RochaDotPng/ProjectLinkplas/public/images/equipa/equipa.jpg

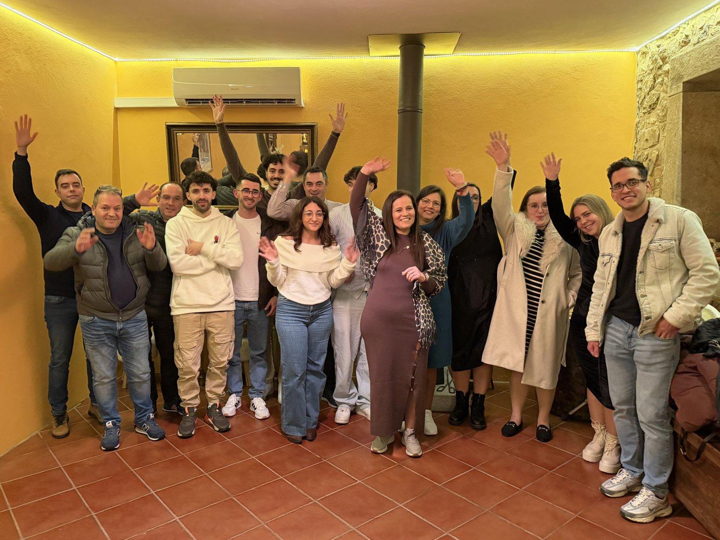
public/images/equipa/equipa.jpg
