RochaDotPng/ProjectLinkplas/public/images/equipa/rui-silva.jpg

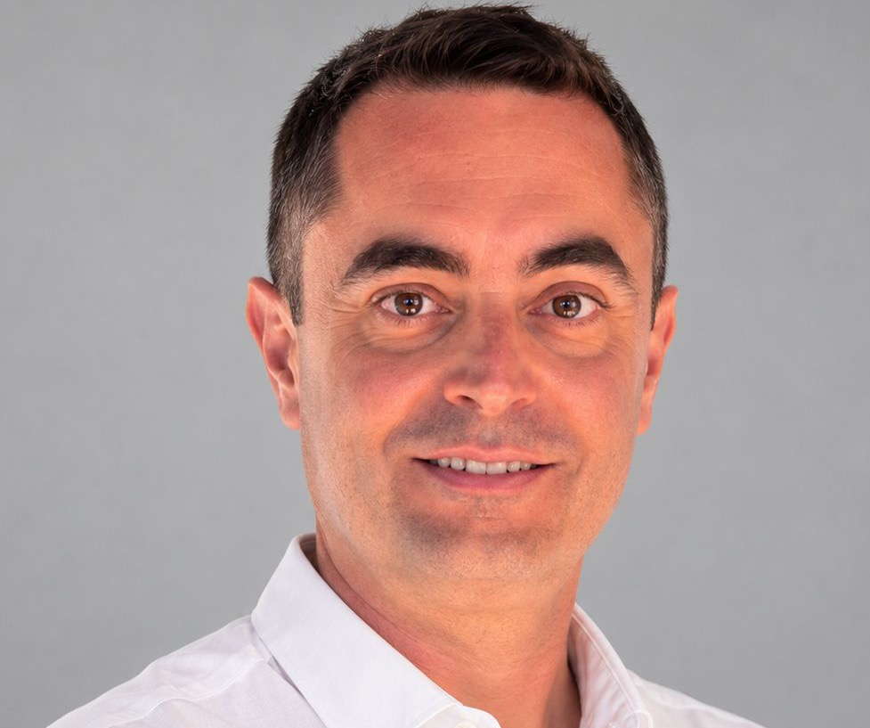
public/images/equipa/rui-silva.jpg
