RochaDotPng/ProjectLinkplas/README.md

# LinkPlas Website

All development made by:

- André Silva
- José Seiça
