RochaDotPng/ProjectLinkplas/public/files/ZØR_LINKPLAS_Kit.pdf

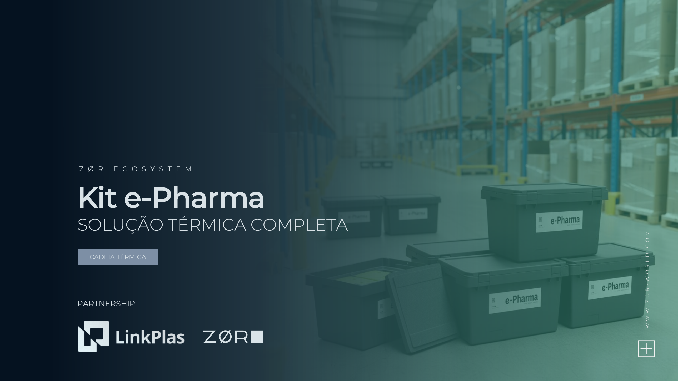
[picture p3: page 1]

### Z Ø R E C O S Y S T E M

# Kit

e

# -Pharma

# SOLUÇÃO TÉRMICA COMPLETA

CADEIA TÉRMICA

W W W . Z O R - W O R L D . C O M

## PARTNERSHIP

2

# Departamento de I&D

### D E S I G N & E N G E N H A R I A

Uma equipa multidisciplinar composta por especialistas em diferentes áreas, como a biotecnologia, a alimentação, a biomedicina, a engenharia, o design e a cadeia de frio, desenvolve-se através de uma perspetiva de Design Thinking, combinando a experiência profissional com mentalidades criativas.

# Sustentabilidade

### I N I C I A T I V A S

A ZØR tem vindo a desenvolver soluções cada vez mais responsáveis e sustentáveis, associando a cada produto novas iniciativas que refletem esse compromisso: GoGreen, para materiais de menor impacto ambiental; Re-Kool, para sistemas com componentes retornáveis e reutilizáveis; e ZØR Loop, para modelos totalmente circulares. Um percurso contínuo rumo a uma produção mais consciente.

### C Â M A R A T E R M O D I N Â M I C A + S I M U L A Ç Ã O V I R T U A L

Laboratório de performance térmica dedicado a qualificações em ambiente controlado
e validações em contexto operacional de soluções da cadeia térmica. O laboratório dispõe de uma equipa qualificada, uma câmara climática walk-in que permite simular diferentes perfis térmicas exteriores e um software avançado de simulação numérica.

# Laboratório

# GøGreen

# Missão e Visão

### Z Ø R T H E R M A L

O ZØR World é um grupo que reúne várias empresas e competências complementares, dentro e fora da cadeia térmica, unidas por uma visão comum de inovação e sustentabilidade. No seu núcleo está a ZØR Thermal, dedicada ao desenvolvimento de soluções para a cadeia térmica, que integra o ZØR FabLab e uma equipa de I&D focada na melhoria contínua de desempenho e eficiência. Através da ZØR Monitoring, oferecemos serviços digitais de gestão e monitorização com sistemas conectados, reforçando o controlo e a fiabilidade em toda a operação.

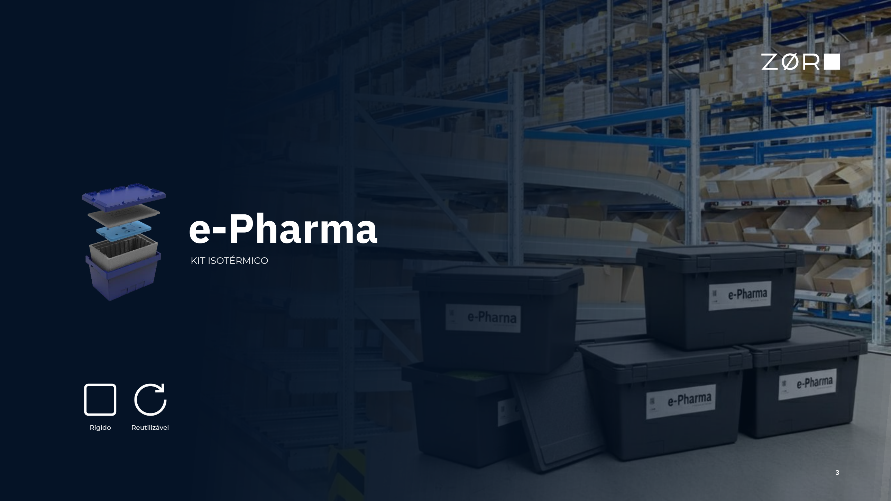
[picture p4: page 3]

# e-Pharma

### KIT ISOTÉRMICO

3

Rígido Reutilizável

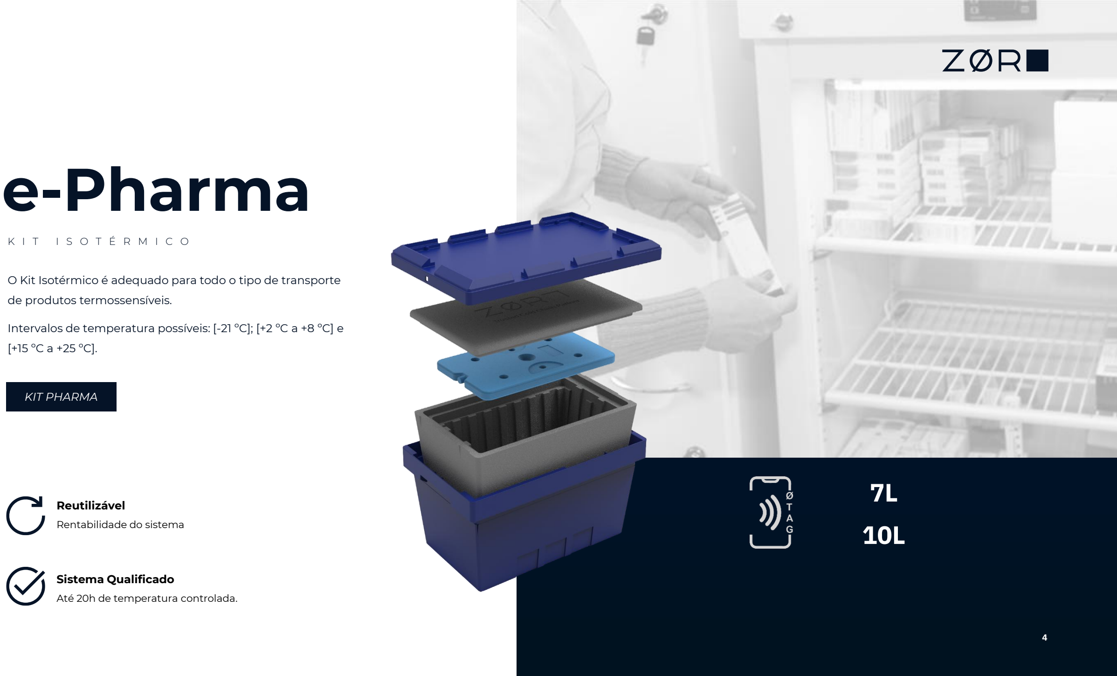
[picture p5: page 4]

O Kit Isotérmico é adequado para todo o tipo de transporte de produtos termossensíveis.

Intervalos de temperatura possíveis: [

-21 ºC]; [+2 ºC a +8 ºC] e

[+15 ºC a +25 ºC]. e-Pharma

K I T I S O T É R M I C O

KIT PHARMA

4

1

0

L

7L

Sistema Qualificado
Até

2

0h de temperatura controlada

Reutilizável
Rentabilidade do sistema

# e-Pharma Kit isotérmico

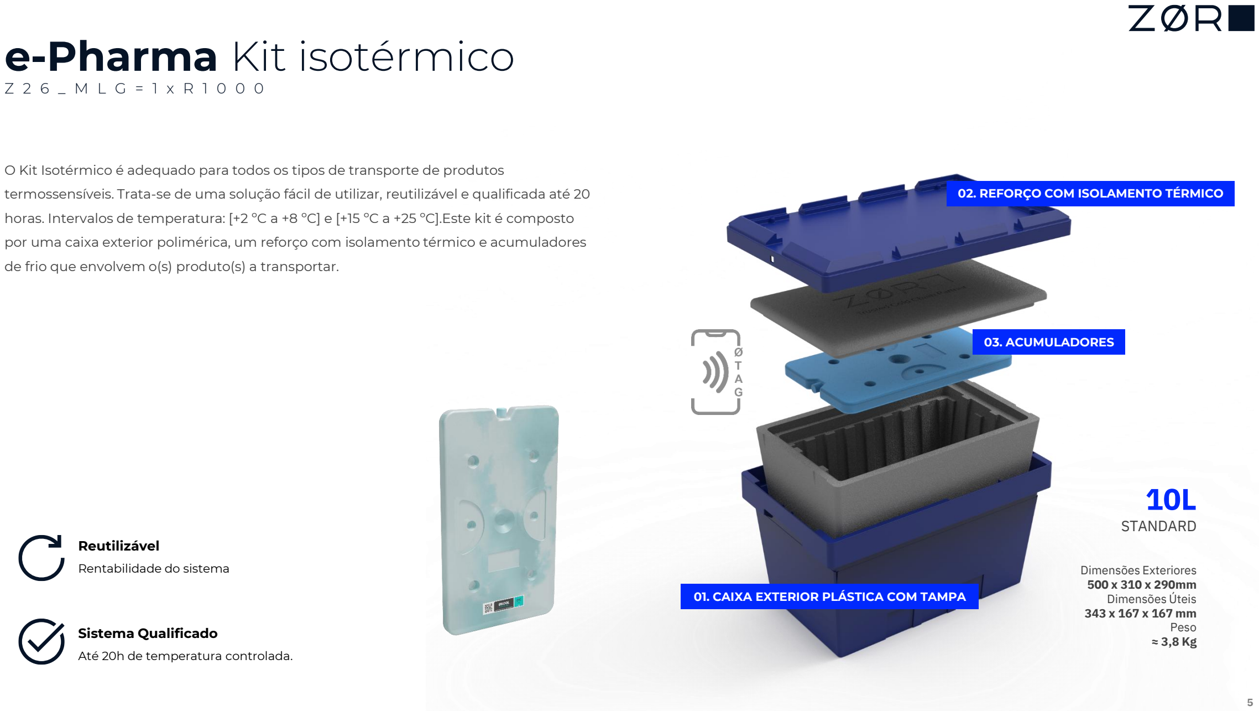
[picture p6: page 5]

5

### Z 2 6 _ M L G = 1 x R 1 0 0 0

10L

STANDARD

Dimensões Exteriores
500 x 310 x 290mm
Dimensões Úteis
343 x 167 x 167 mm
Peso
≈ 3,8 Kg

O Kit Isotérmico é adequado para todos os tipos de transporte de produtos termossensíveis. Trata-se de uma solução fácil de utilizar, reutilizável e qualificada até 20 horas. Intervalos de temperatura: [+2 ºC a +8 ºC] e [+15 ºC a +25 ºC].Este kit é composto por uma caixa exterior polimérica, um reforço com isolamento térmico e acumuladores de frio que envolvem o(s) produto(s) a transportar.

### 02. REFORÇO COM ISOLAMENTO TÉRMICO

### 01. CAIXA EXTERIOR PLÁSTICA COM TAMPA

### 03. ACUMULADORES

Sistema Qualificado
Até 20h de temperatura controlada.

Reutilizável
Rentabilidade do sistema

# e-Pharma Kit isotérmico

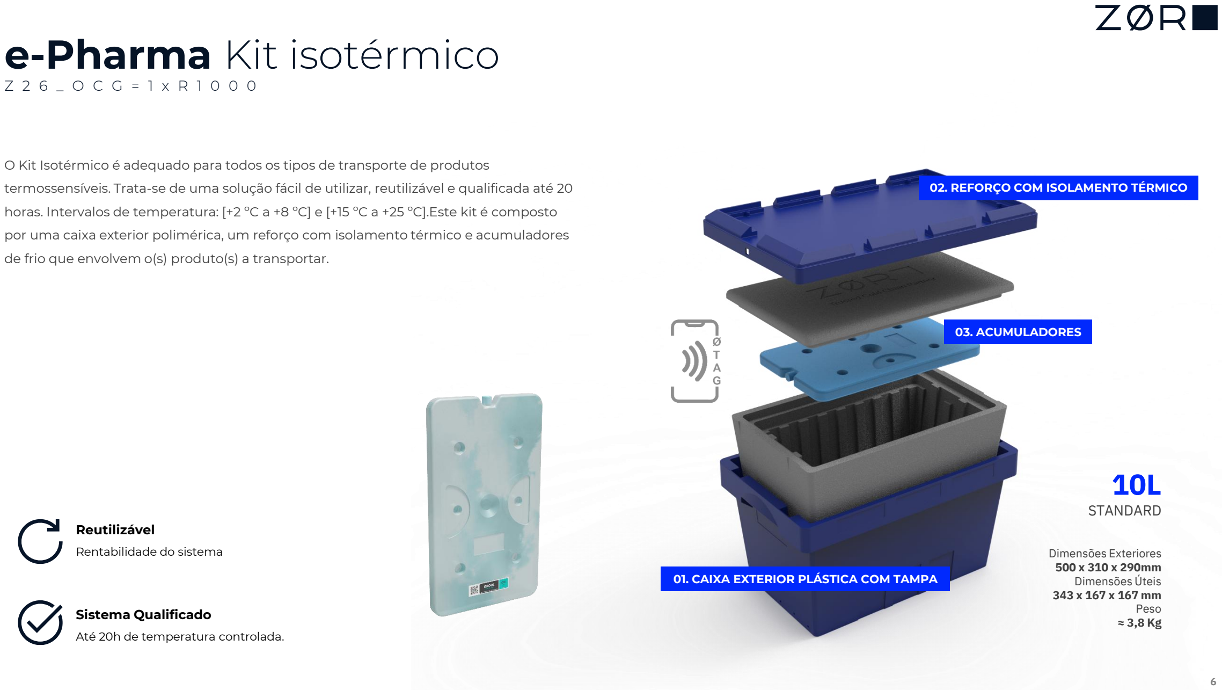
[picture p7: page 6]

6

### Z 2 6 _ O C G = 1 x R 1 0 0 0

10L

STANDARD

Dimensões Exteriores
500 x 310 x 290mm
Dimensões Úteis
343 x 167 x 167 mm
Peso
≈ 3,8 Kg

### 02. REFORÇO COM ISOLAMENTO TÉRMICO

### 01. CAIXA EXTERIOR PLÁSTICA COM TAMPA

### 03. ACUMULADORES

Sistema Qualificado
Até 20h de temperatura controlada.

Reutilizável
Rentabilidade do sistema

O Kit Isotérmico é adequado para todos os tipos de transporte de produtos termossensíveis. Trata-se de uma solução fácil de utilizar, reutilizável e qualificada até 20 horas. Intervalos de temperatura: [+2 ºC a +8 ºC] e [+15 ºC a +25 ºC].Este kit é composto por uma caixa exterior polimérica, um reforço com isolamento térmico e acumuladores de frio que envolvem o(s) produto(s) a transportar.

# e-Pharma Kit isotérmico

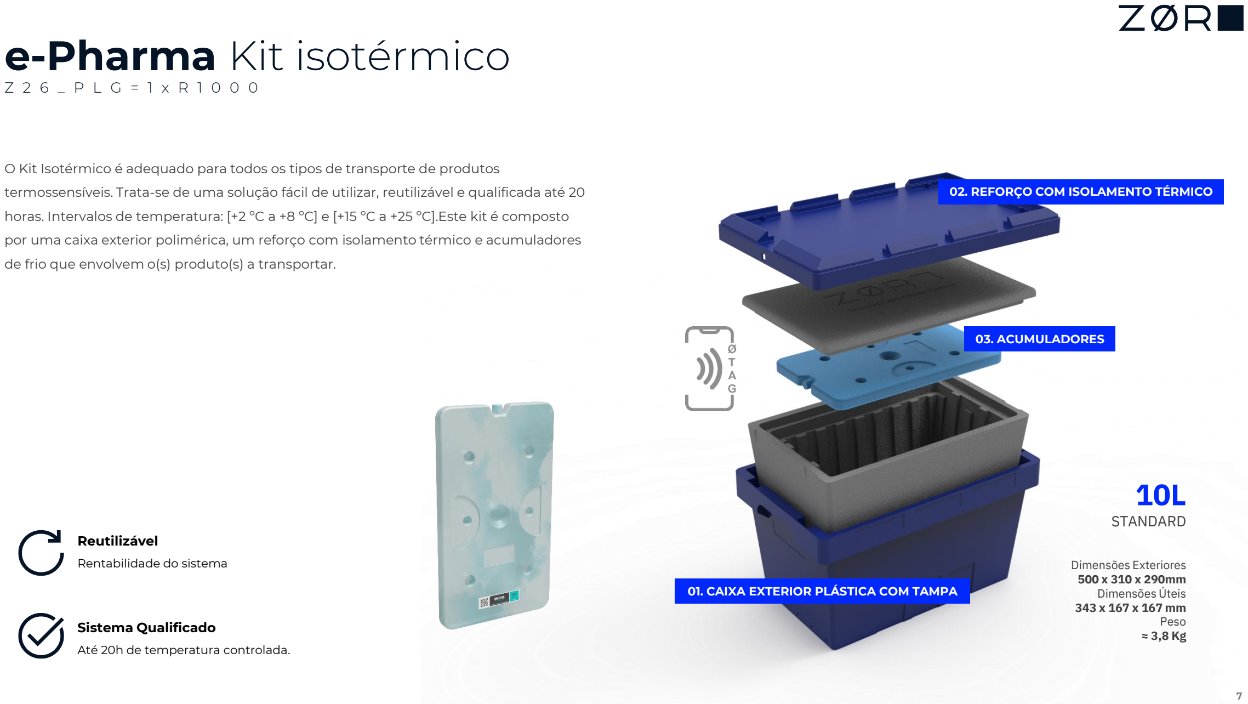
[picture p8: page 7]

7

10L

STANDARD

Dimensões Exteriores
500 x 310 x 290mm
Dimensões Úteis
343 x 167 x 167 mm
Peso
≈ 3,8 Kg

### Z 2 6 _ P L G = 1 x R 1 0 0 0

### 02. REFORÇO COM ISOLAMENTO TÉRMICO

### 01. CAIXA EXTERIOR PLÁSTICA COM TAMPA

### 03. ACUMULADORES

Sistema Qualificado
Até 20h de temperatura controlada.

Reutilizável
Rentabilidade do sistema

O Kit Isotérmico é adequado para todos os tipos de transporte de produtos termossensíveis. Trata-se de uma solução fácil de utilizar, reutilizável e qualificada até 20 horas. Intervalos de temperatura: [+2 ºC a +8 ºC] e [+15 ºC a +25 ºC].Este kit é composto por uma caixa exterior polimérica, um reforço com isolamento térmico e acumuladores de frio que envolvem o(s) produto(s) a transportar.

# e-Pharma Kit isotérmico

# e-Pharma Kit isotérmico

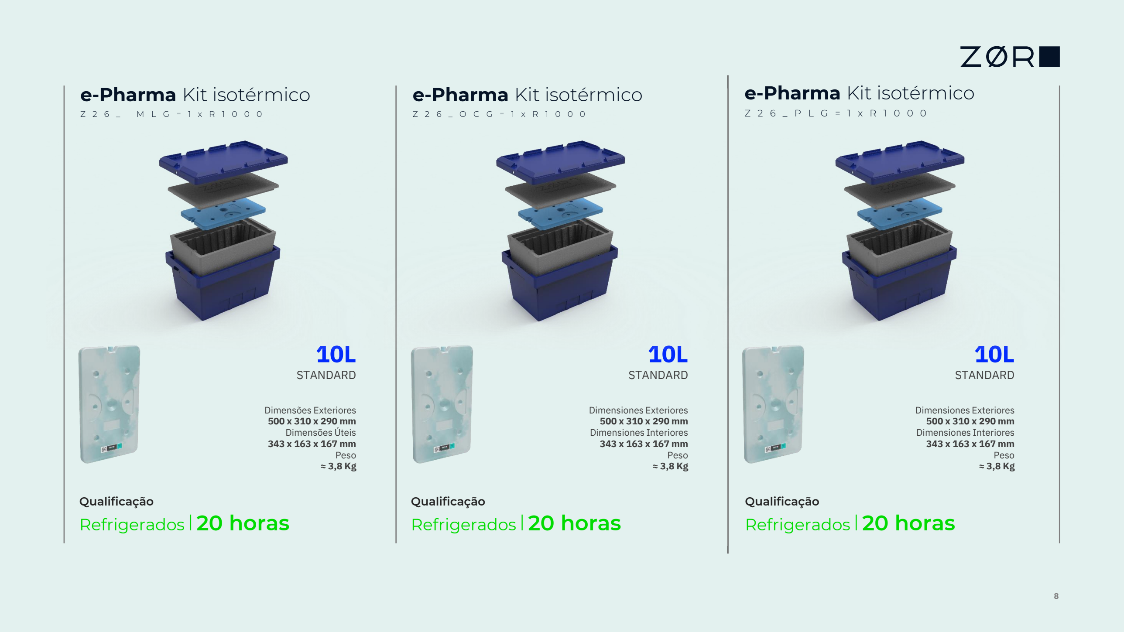
[picture p9: page 8]

10L

STANDARD

Dimensiones Exteriores
500 x 310 x 290 mm
Dimensiones Interiores
343 x 163 x 167 mm
Peso
≈ 3,8 Kg

8

Z 2 6 _ M L G = 1 x R 1 0 0 0

Z 2 6 _ O C G = 1 x R 1 0 0 0

# e-Pharma Kit isotérmico

Z 2 6 _ P L G = 1 x R 1 0 0 0

# Refrigerados l 20 horas

### Qualificação

# Refrigerados l 20 horas

### Qualificação

# Refrigerados l 20 horas

### Qualificação

10L

STANDARD

Dimensões Exteriores
500 x 310 x 290 mm
Dimensões Úteis
343 x 163 x 167 mm
Peso
≈ 3,8 Kg

10L

STANDARD

Dimensiones Exteriores
500 x 310 x 290 mm
Dimensiones Interiores
343 x 163 x 167 mm
Peso
≈ 3,8 Kg

# e-Pharma Kit isotérmico

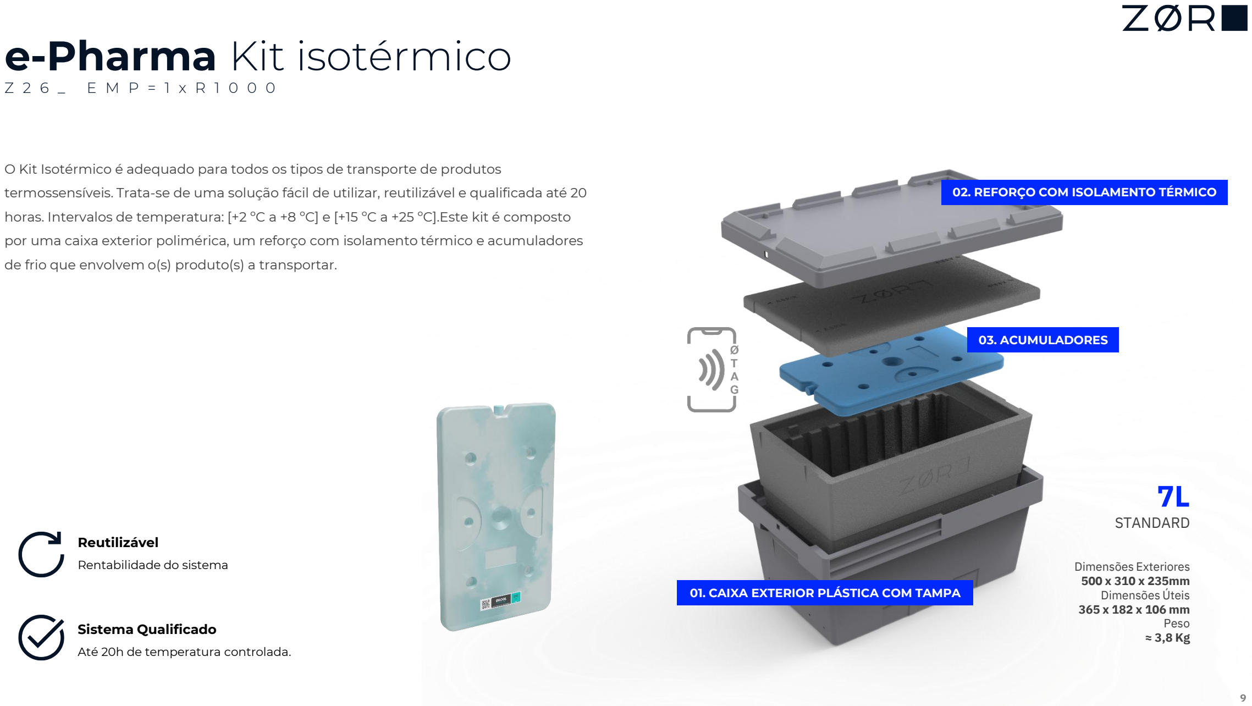
[picture p10: page 9]

9

7L

STANDARD

Dimensões Exteriores
500 x 310 x 235mm
Dimensões Úteis
365 x 182 x 106 mm
Peso
≈ 3,8 Kg

### Z 2 6 _ E M P = 1 x R 1 0 0 0

### 02. REFORÇO COM ISOLAMENTO TÉRMICO

### 01. CAIXA EXTERIOR PLÁSTICA COM TAMPA

### 03. ACUMULADORES

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

Sistema Qualificado
Até 20h de temperatura controlada.

Reutilizável
Rentabilidade do sistema

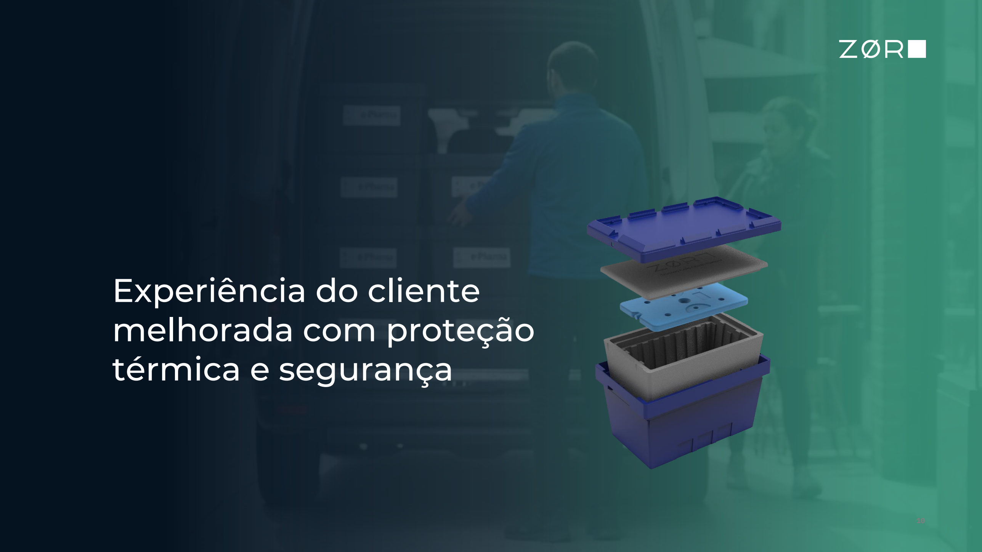
[picture p11: page 10]

10

# Experiência do cliente melhorada com proteção térmica e segurança

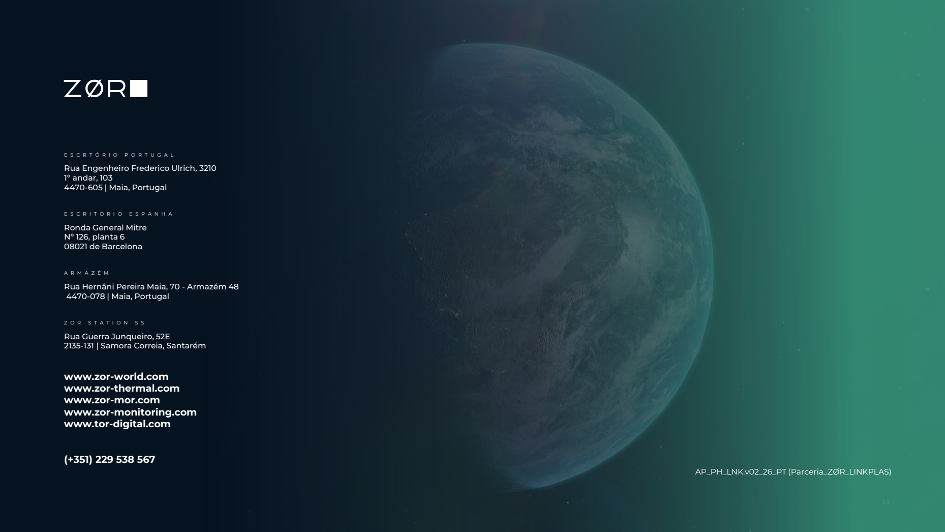
[picture p12: page 11]

11

E S C R T Ó R I O P O R T U G A L
Rua Engenheiro Frederico Ulrich, 3210 1º andar, 103
4470-605 | Maia, Portugal

E S C R I T Ó R I O E S P A NHA
Ronda General Mitre
Nº 126, planta 6
08021 de Barcelona

A R M A Z É M
Rua Hernâni Pereira Maia, 70 - Armazém 48
4470-078 | Maia, Portugal

Z O R S T A T I O N S S
Rua Guerra Junqueiro, 52E
2135-131 | Samora Correia, Santarém

### www.zor-world.com www.zor-thermal.com www.zor-mor.com www.zor-monitoring.com www.tor-digital.com

(+351) 229 538 567
AP_PH_LNK.v02_26_PT (Parceria_ZØR_LINKPLAS)
