RochaDotPng/ProjectLinkplas/src/assets/logos/LEIA-ME.md

# Logótipos de clientes e parceiros

Os ficheiros desta pasta aparecem sozinhos na faixa "Mais de 20 clientes ativos confiam na
LinkPlas" da página inicial e na lista de parceiros. Não é preciso mexer no código.

- Formatos: SVG (preferido), PNG ou WebP, com fundo transparente. Um JPG também serve: o fundo
  branco desaparece na faixa da página inicial, mas a imagem só fica bem sobre fundos claros.
- Use a versão do logótipo feita para fundo claro. Uma versão com letras brancas ou muito claras
  (feita para fundo escuro) quase não se lê no site.
- Nome do ficheiro: o nome da empresa em minúsculas, sem espaços nem acentos, por exemplo
  `plural.svg`, `platec.svg`, `zor.svg`, `polisport.svg`, `empifarma.svg`, `ocp.svg`,
  `medlog.svg`, `coprax.svg`.
- Um ficheiro com o nome de um parceiro da lista substitui o nome em texto desse parceiro.
  Qualquer outro ficheiro é acrescentado à faixa, com o nome do ficheiro como texto alternativo.
- Enquanto a pasta não tiver logótipos, a faixa mostra os nomes dos parceiros em texto.
- Quando os logótipos não cabem numa linha, a faixa passa a deslizar devagar, sem parar.
