RochaDotPng/ProjectLinkplas/public/images/acumulador.png

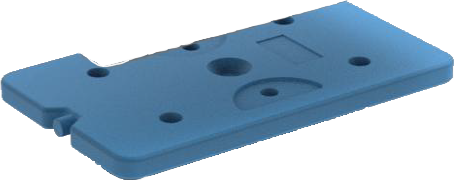
public/images/acumulador.png
