RochaDotPng/ProjectLinkplas/public/images/anilha_intercalar-uso.png

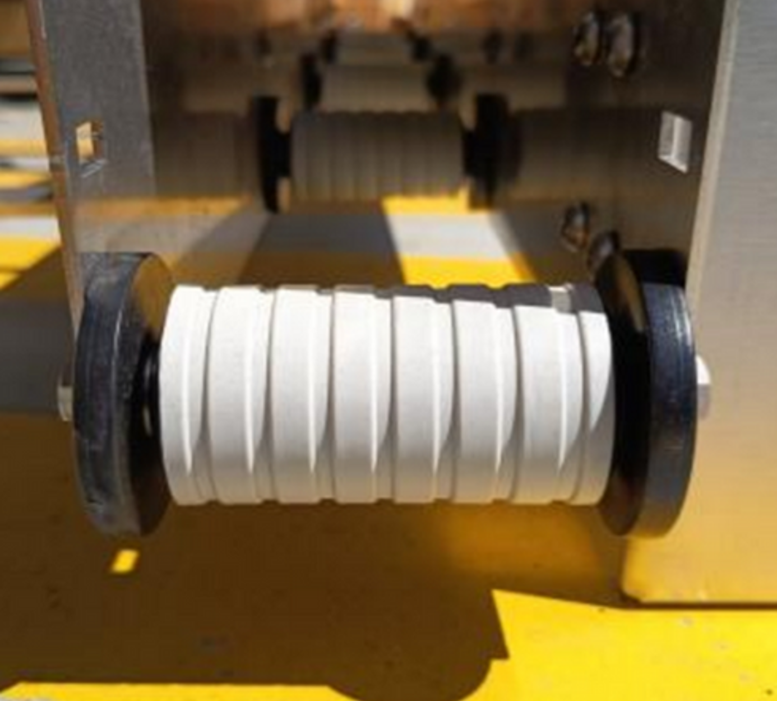
public/images/anilha_intercalar-uso.png
