RochaDotPng/ProjectLinkplas/public/images/anilha_intercalar.png

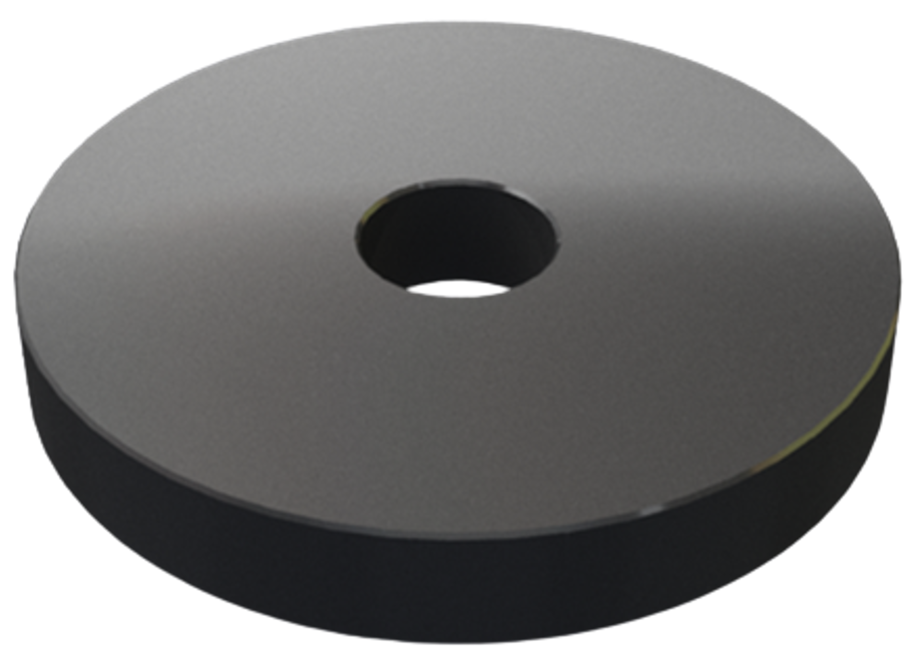
public/images/anilha_intercalar.png
