RochaDotPng/ProjectLinkplas/public/images/caixa-grande.png

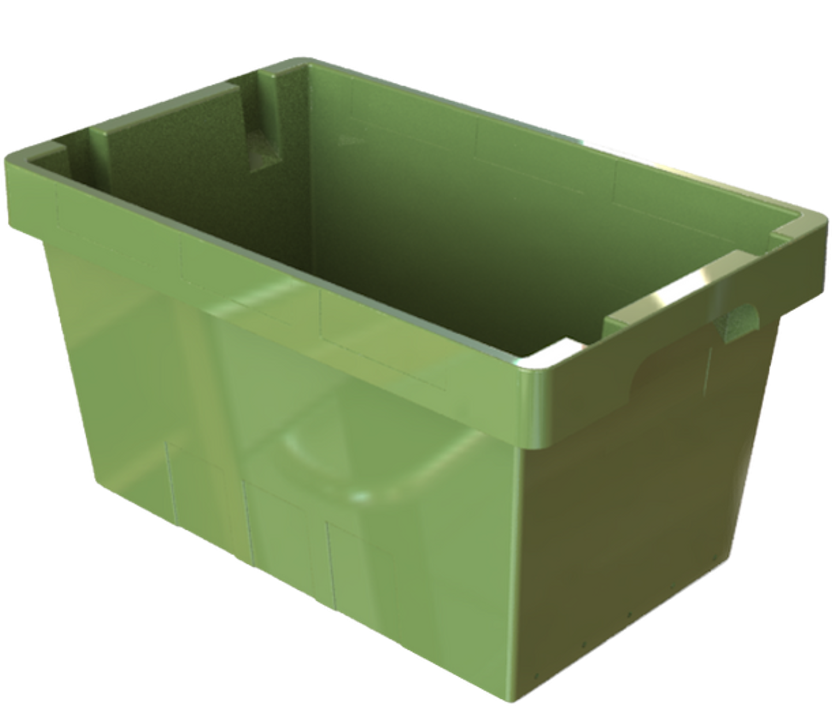
public/images/caixa-grande.png
