RochaDotPng/ProjectLinkplas/public/images/caixa-pequena.png

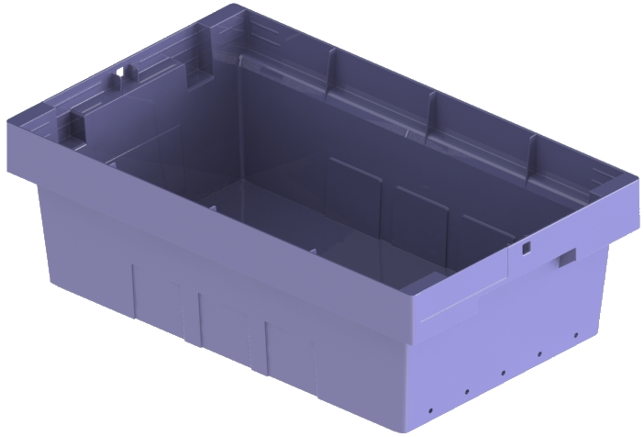
public/images/caixa-pequena.png
