RochaDotPng/ProjectLinkplas/public/images/CaixaEsferovite.png

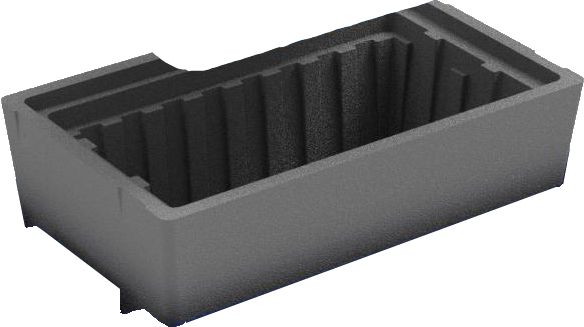
public/images/CaixaEsferovite.png
