RochaDotPng/ProjectLinkplas/public/images/CaixaPlastica.png

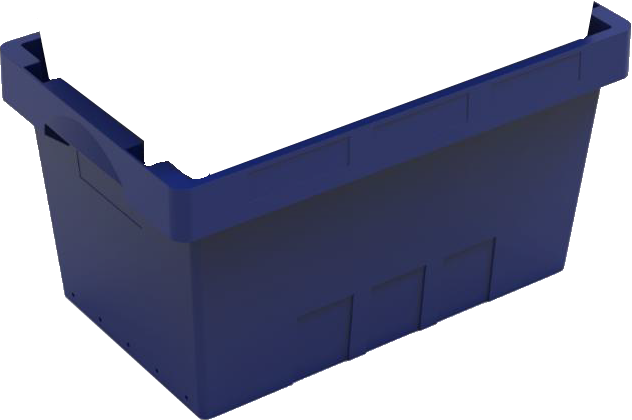
public/images/CaixaPlastica.png
