RochaDotPng/ProjectLinkplas/public/images/company-front.jpg

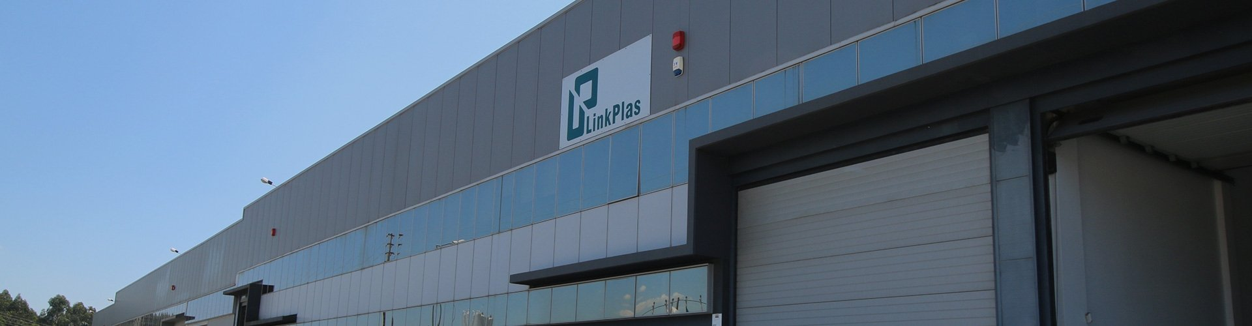
public/images/company-front.jpg
