RochaDotPng/ProjectLinkplas/public/images/empresa/armazem-moldes.jpg

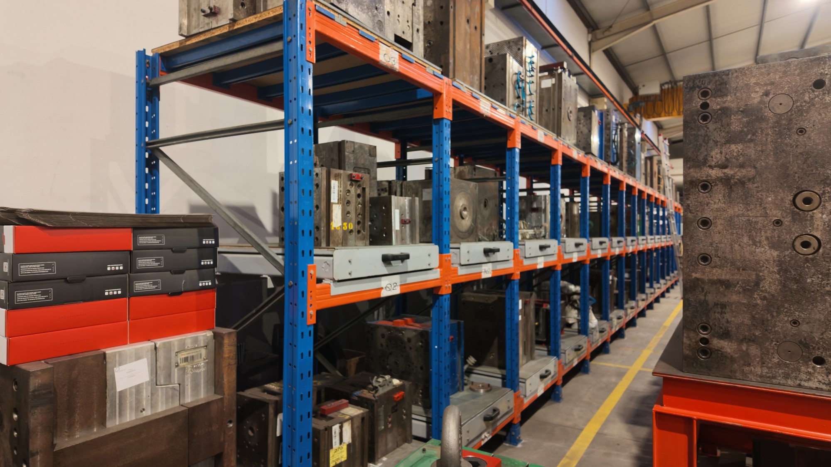
public/images/empresa/armazem-moldes.jpg
