RochaDotPng/ProjectLinkplas/public/images/empresa/linha-producao.webp

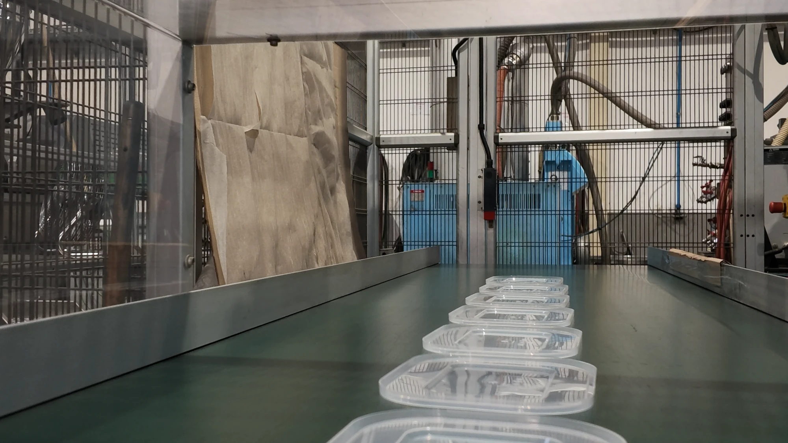
public/images/empresa/linha-producao.webp
