RochaDotPng/ProjectLinkplas/public/images/empresa/maquina-injecao.webp

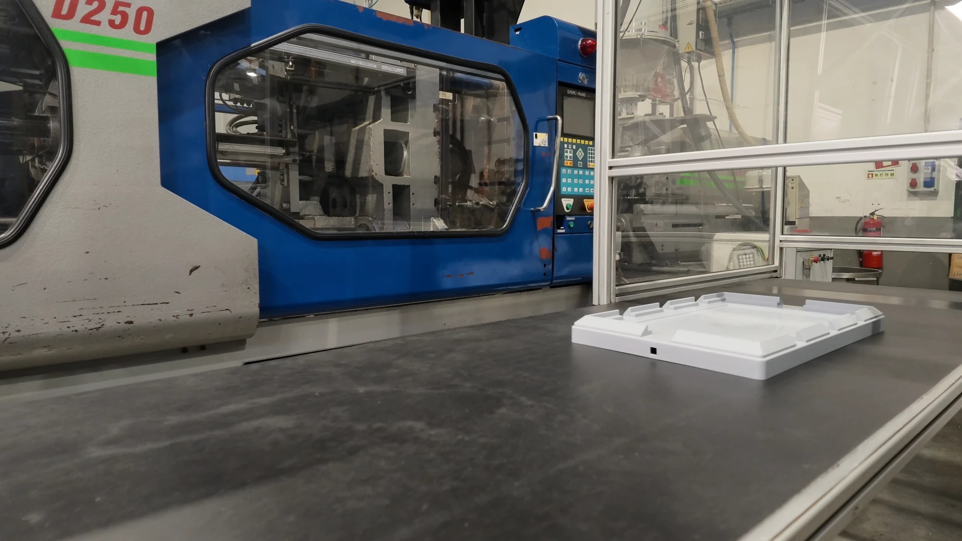
public/images/empresa/maquina-injecao.webp
