RochaDotPng/ProjectLinkplas/public/images/empresa/rececao.webp

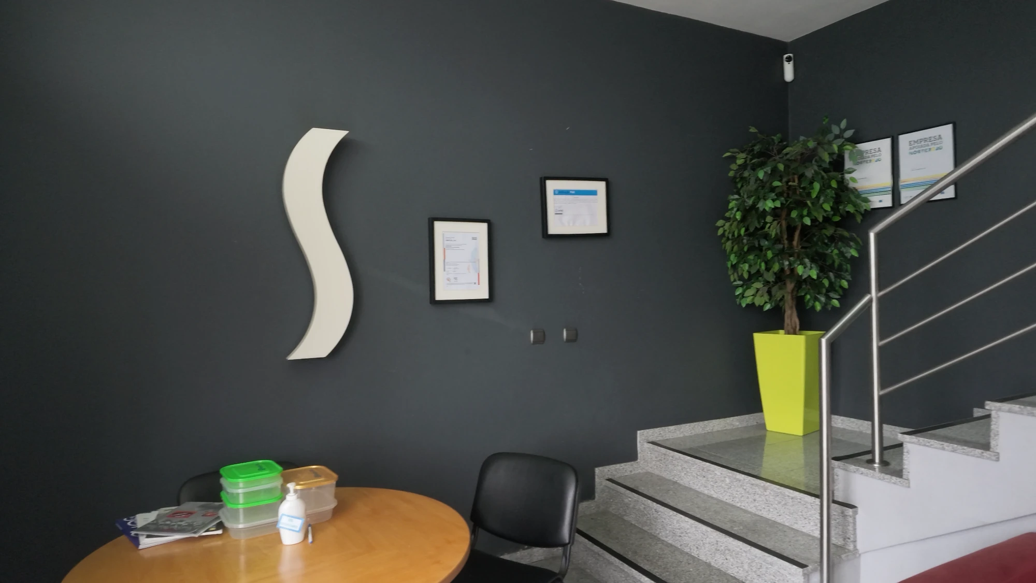
public/images/empresa/rececao.webp
