RochaDotPng/ProjectLinkplas/public/images/equipa/ana-paula.jpg

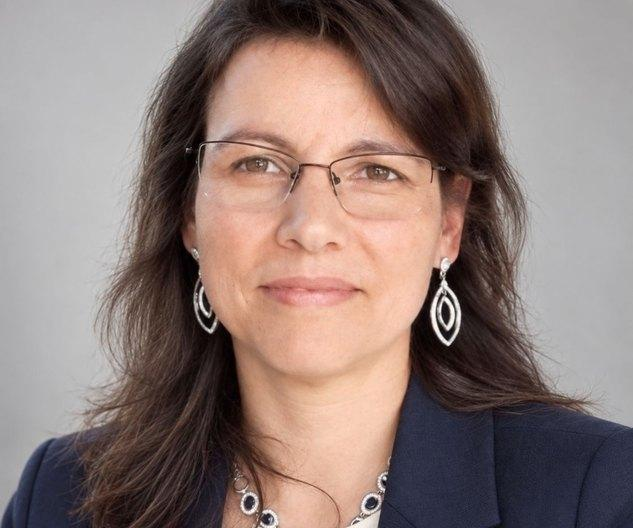
public/images/equipa/ana-paula.jpg
