RochaDotPng/ProjectLinkplas/public/images/equipa/andre-silva.jpg

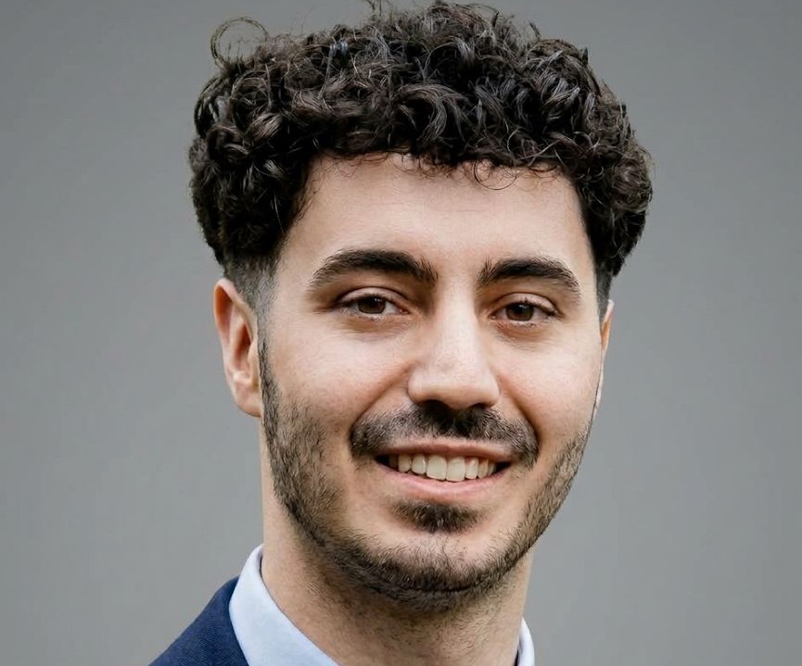
public/images/equipa/andre-silva.jpg
