RochaDotPng/ProjectLinkplas/public/images/equipa/antonio-filipe.jpg

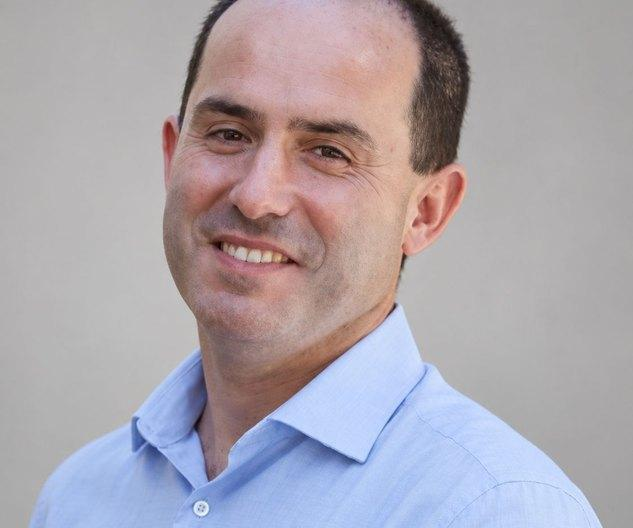
public/images/equipa/antonio-filipe.jpg
