RochaDotPng/ProjectLinkplas/public/images/equipa/paula-rocha.jpg

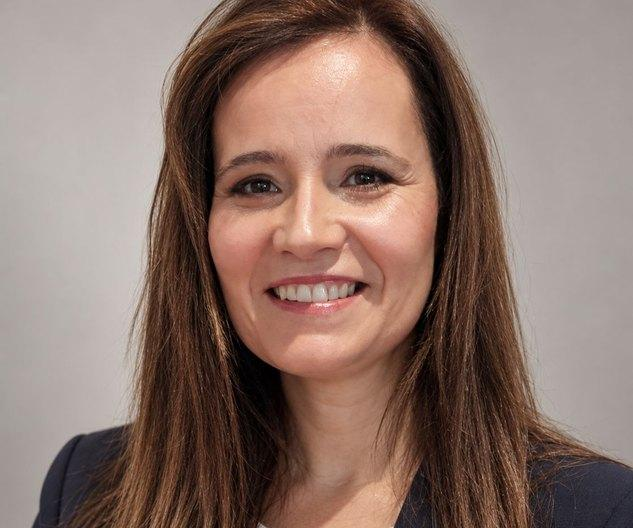
public/images/equipa/paula-rocha.jpg
