RochaDotPng/ProjectLinkplas/public/images/equipa/sandra-tavares.jpg

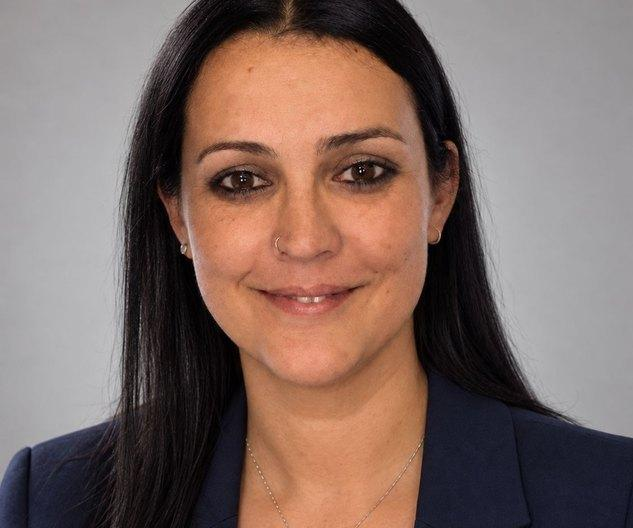
public/images/equipa/sandra-tavares.jpg
