RochaDotPng/ProjectLinkplas/public/images/home-hero-landscape.jpg

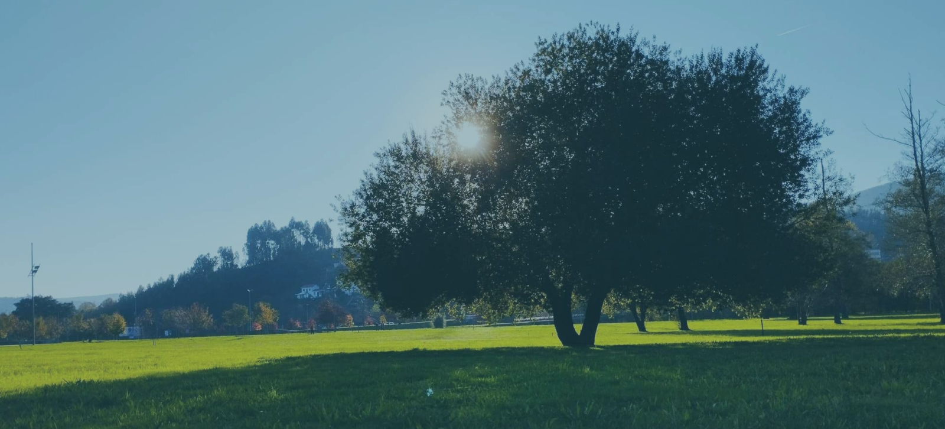
public/images/home-hero-landscape.jpg
