RochaDotPng/ProjectLinkplas/public/images/home/setor-ecocatch.webp

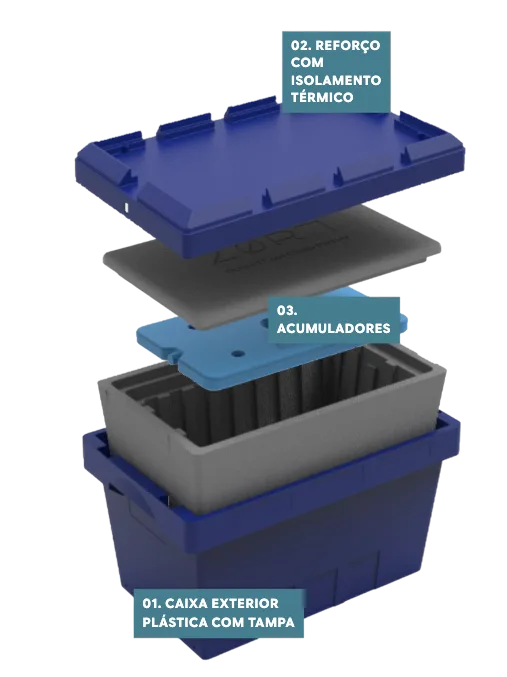
public/images/home/setor-ecocatch.webp
