RochaDotPng/ProjectLinkplas/public/images/home/setor-farmacia.webp

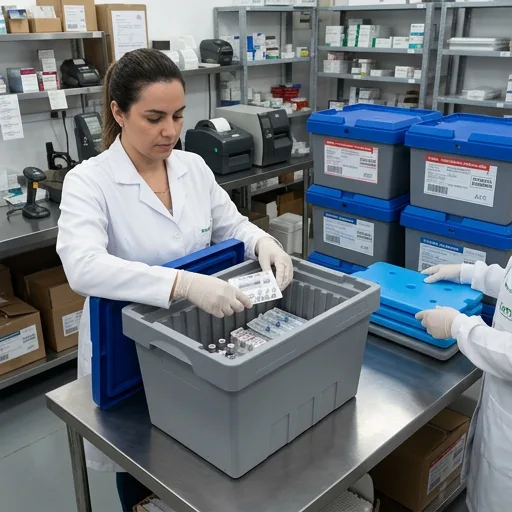
public/images/home/setor-farmacia.webp
