RochaDotPng/ProjectLinkplas/public/images/home/setor-industria.webp

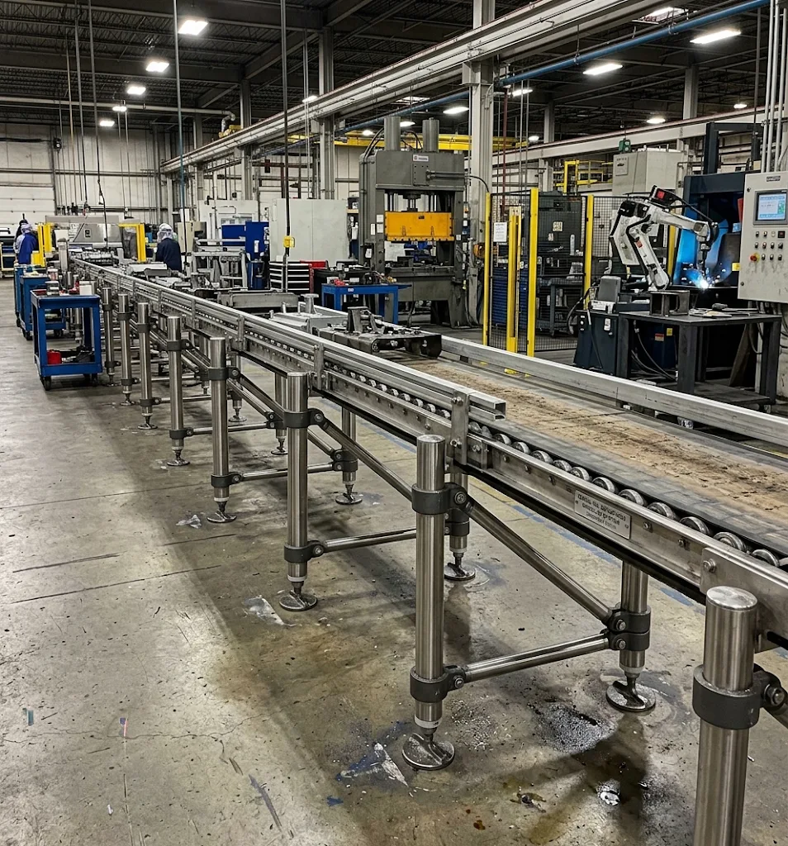
public/images/home/setor-industria.webp
