RochaDotPng/ProjectLinkplas/public/images/home/setor-takeaway.webp

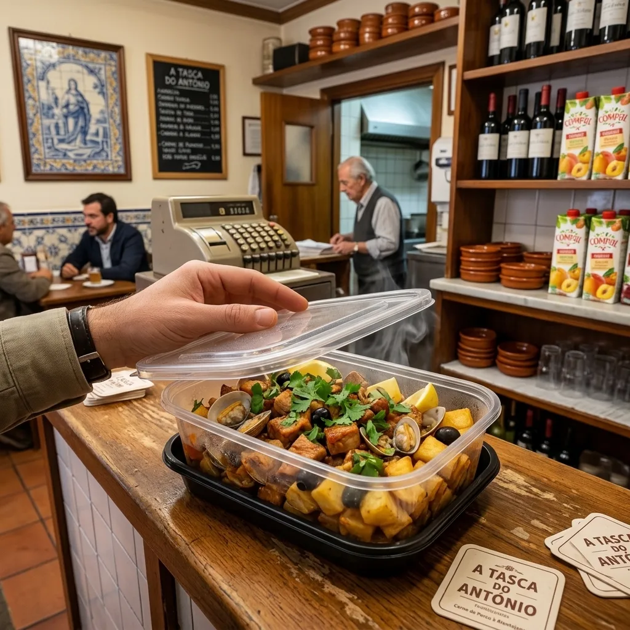
public/images/home/setor-takeaway.webp
