RochaDotPng/ProjectLinkplas/public/images/keepyfarma-stacked-mobile.png

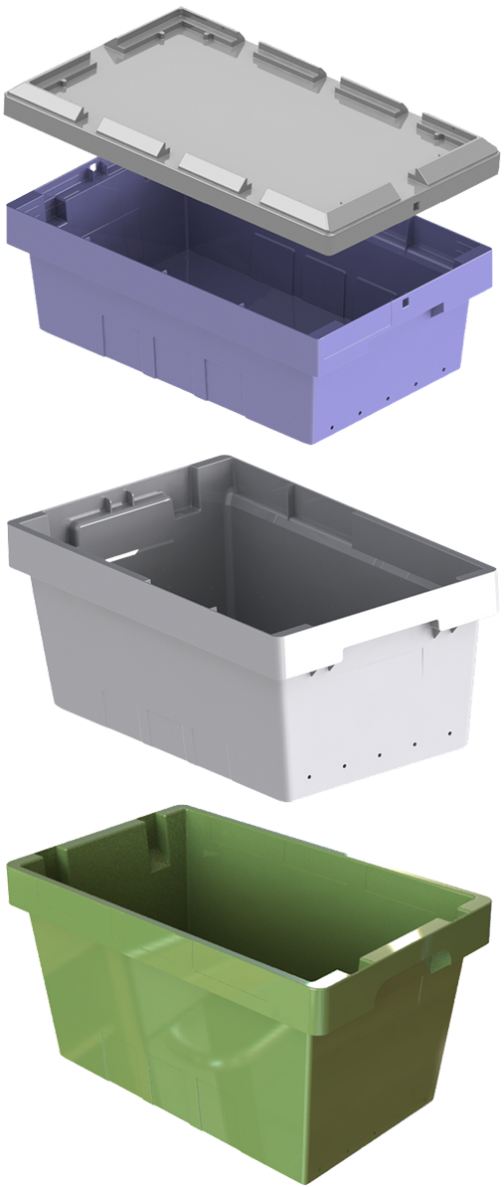
public/images/keepyfarma-stacked-mobile.png
