RochaDotPng/ProjectLinkplas/public/images/keepyfarma-stacked.png

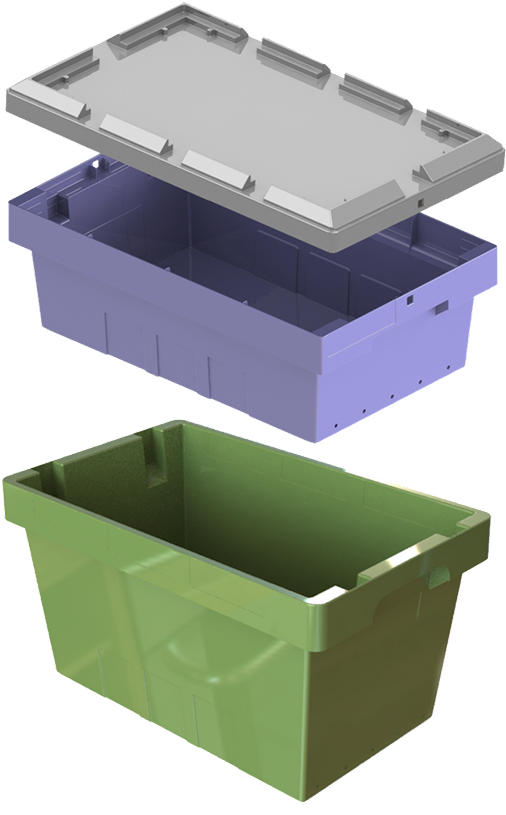
public/images/keepyfarma-stacked.png
