RochaDotPng/ProjectLinkplas/public/images/keepyfarma-white.png

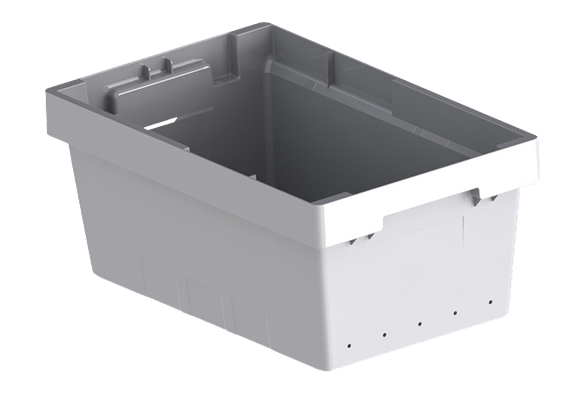
public/images/keepyfarma-white.png
