RochaDotPng/ProjectLinkplas/public/images/noticias/expofarma.jpg

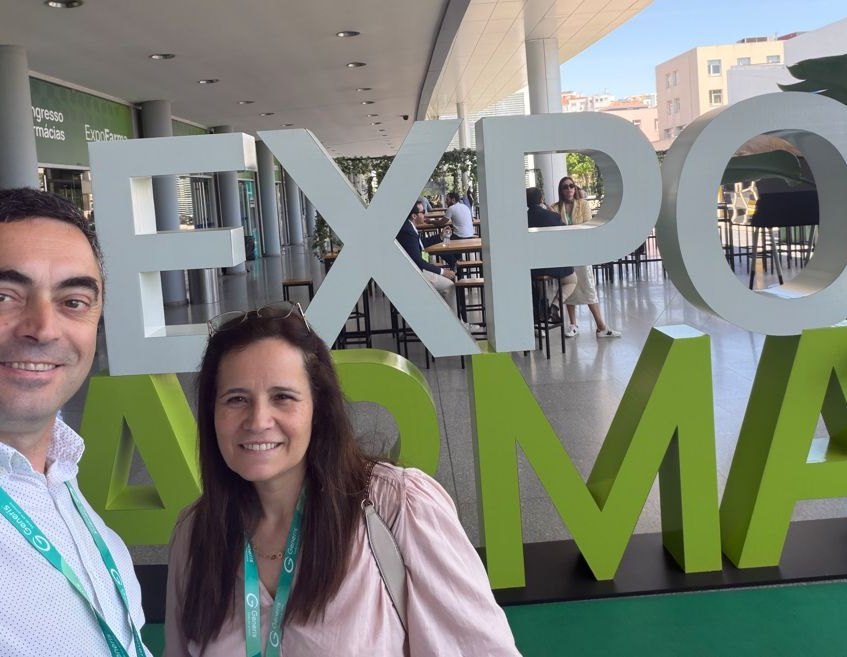
public/images/noticias/expofarma.jpg
