RochaDotPng/ProjectLinkplas/public/images/office2.jpeg

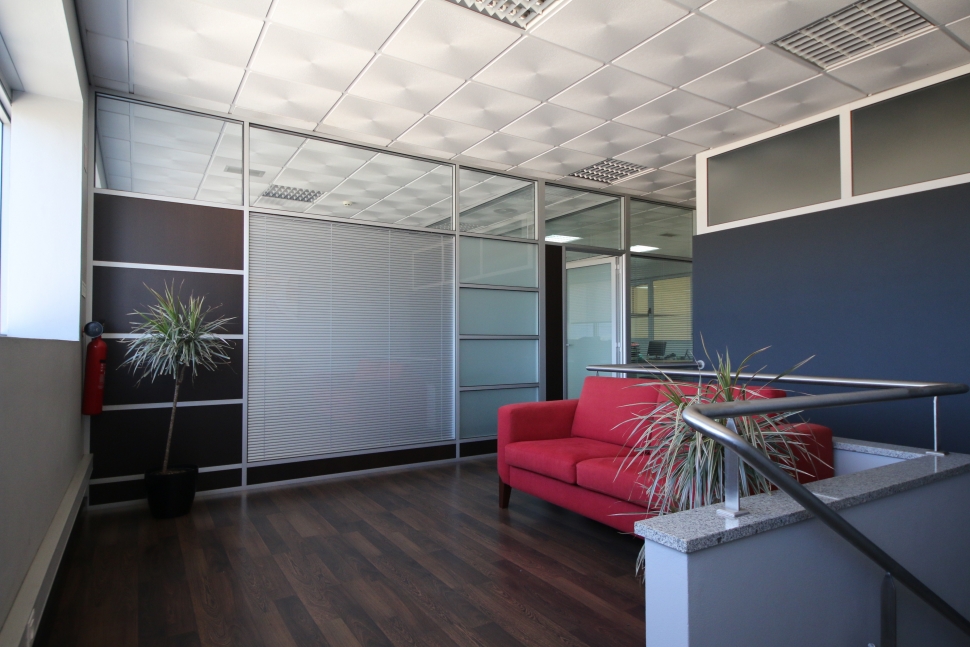
public/images/office2.jpeg
