RochaDotPng/ProjectLinkplas/public/images/perna1.png

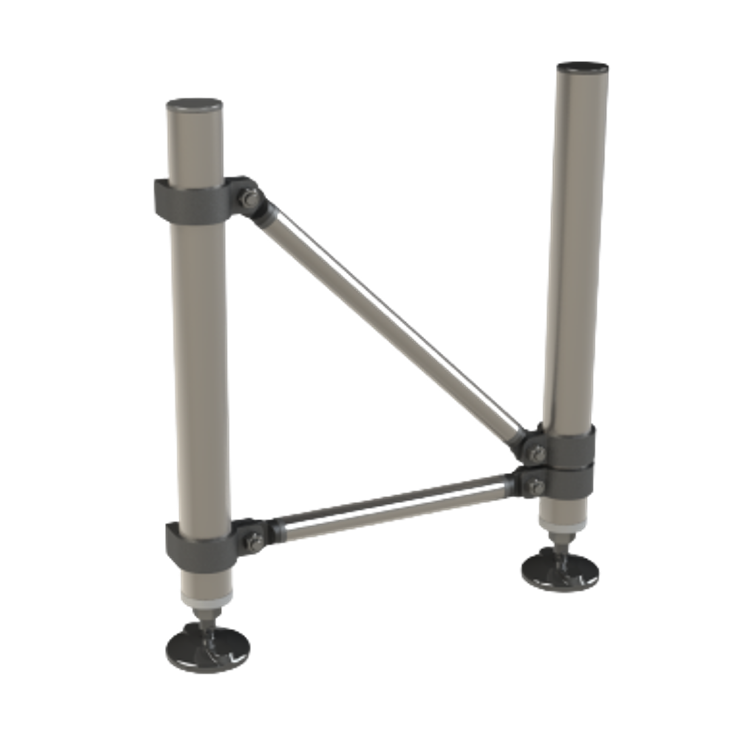
public/images/perna1.png
