RochaDotPng/ProjectLinkplas/public/images/profile_ceo.jpg

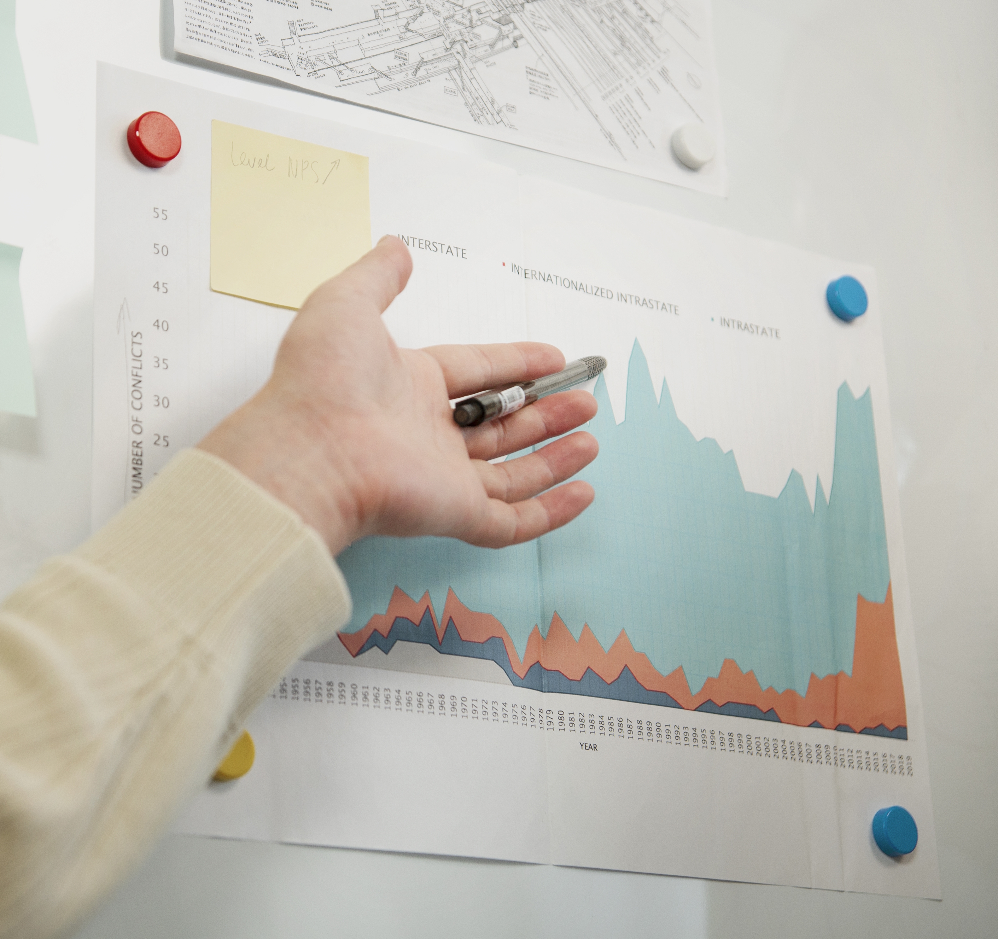
public/images/profile_ceo.jpg
