RochaDotPng/ProjectLinkplas/public/images/soldadura-ultrassons.jpg

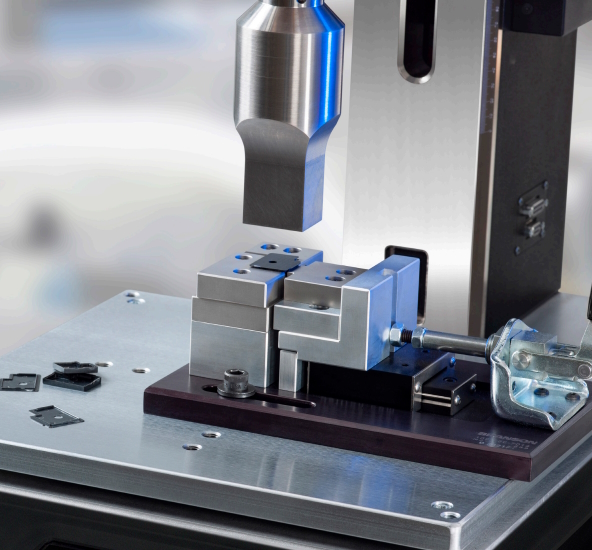
public/images/soldadura-ultrassons.jpg
