RochaDotPng/ProjectLinkplas/public/images/sustainability-1.jpg

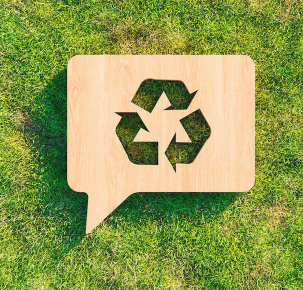
public/images/sustainability-1.jpg
