RochaDotPng/ProjectLinkplas/public/images/sustainability-2.jpg

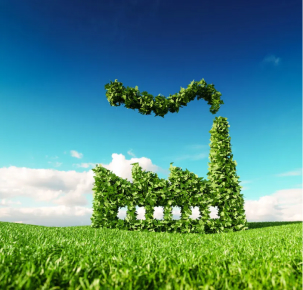
public/images/sustainability-2.jpg
