RochaDotPng/ProjectLinkplas/public/images/sustainability-3.jpg

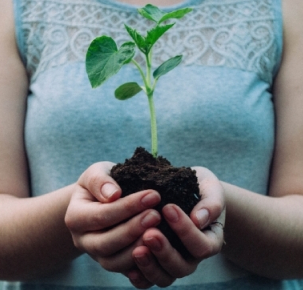
public/images/sustainability-3.jpg
