RochaDotPng/ProjectLinkplas/public/images/tampa-caixa.png

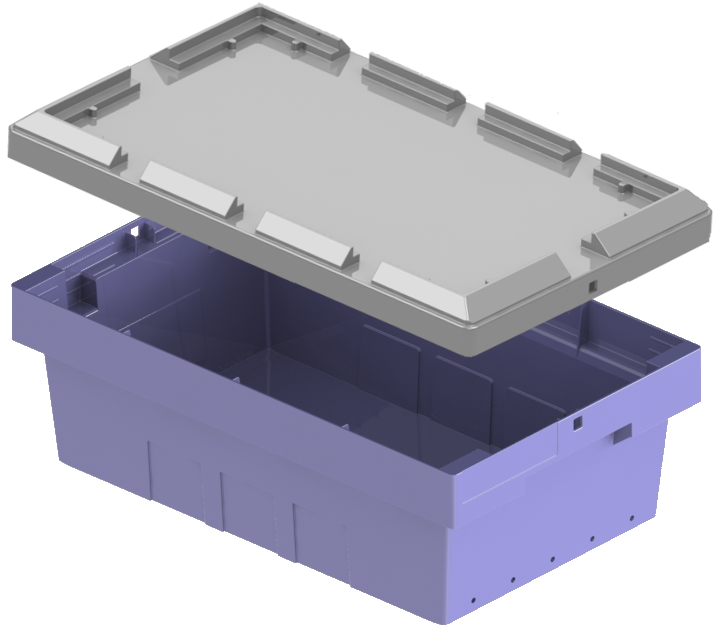
public/images/tampa-caixa.png
