RochaDotPng/ProjectLinkplas/public/images/tampa-veio-uso.png

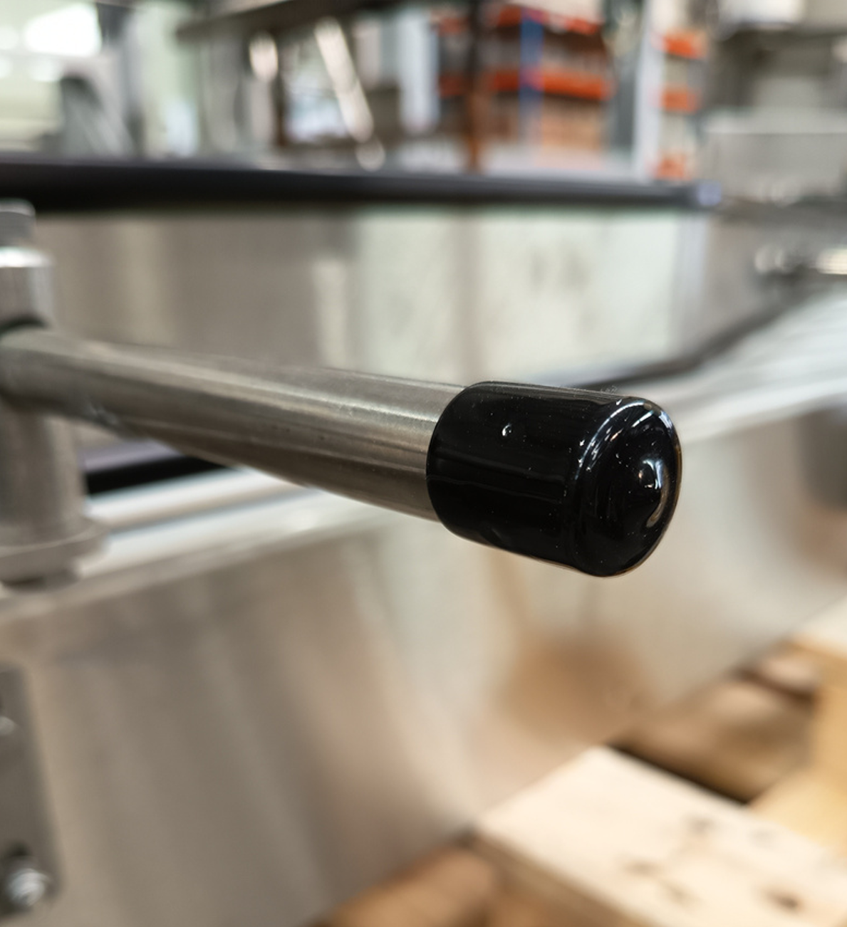
public/images/tampa-veio-uso.png
