RochaDotPng/ProjectLinkplas/public/images/tampa-veio.png

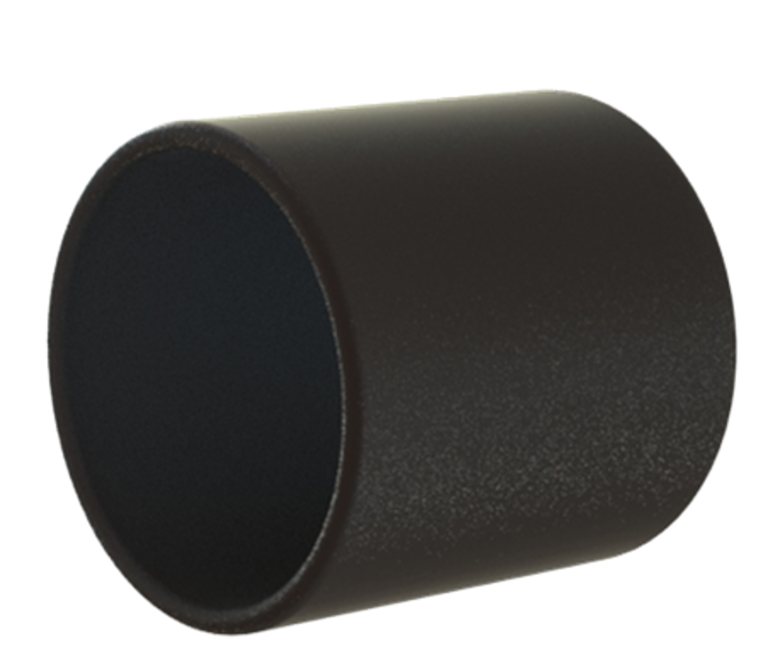
public/images/tampa-veio.png
