RochaDotPng/ProjectLinkplas/public/images/tampa.png

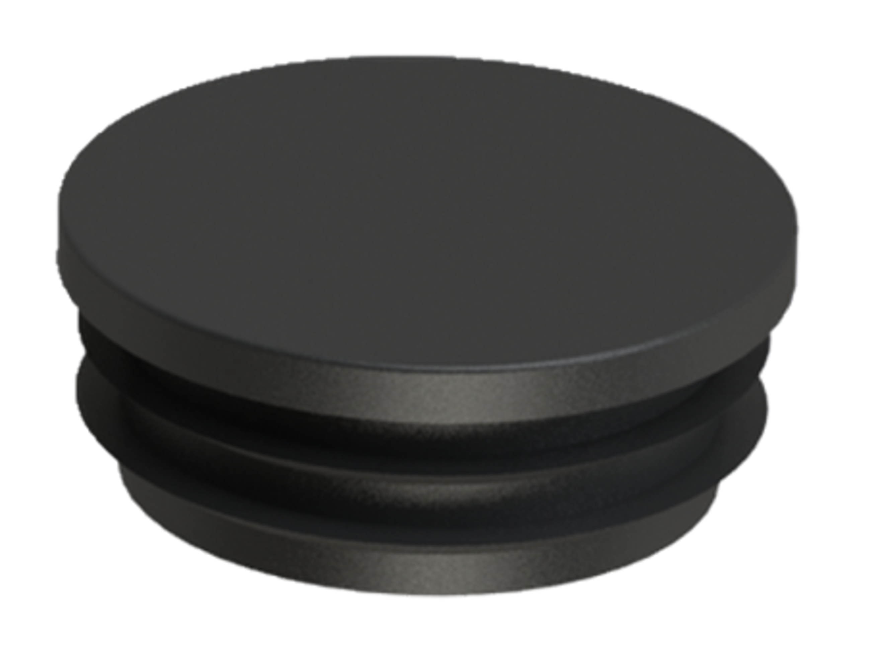
public/images/tampa.png
