RochaDotPng/ProjectLinkplas/public/images/TampaEsferovite.png

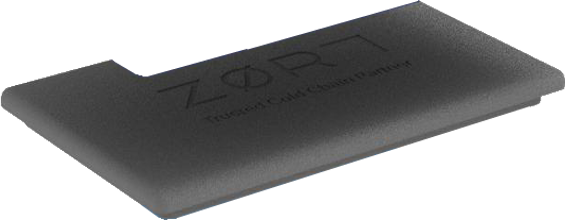
public/images/TampaEsferovite.png
