RochaDotPng/ProjectLinkplas/public/images/TampaPlastico.png

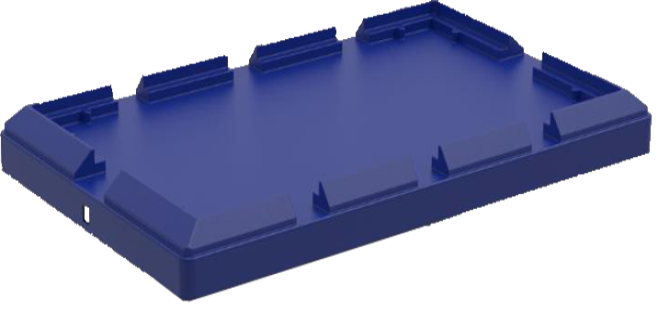
public/images/TampaPlastico.png
