RochaDotPng/ProjectLinkplas/public/images/tupperlink_colored.png

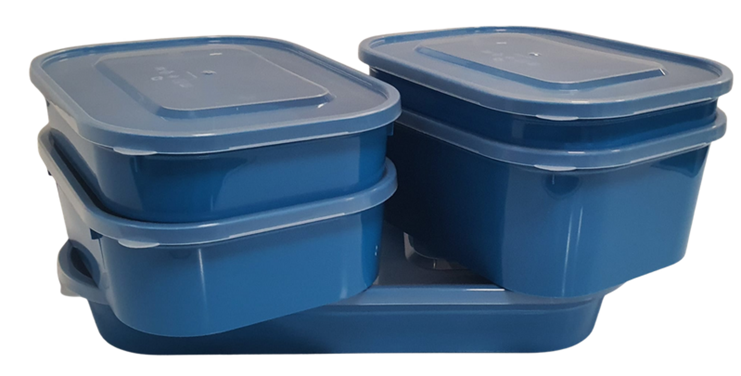
public/images/tupperlink_colored.png
