RochaDotPng/ProjectLinkplas/public/LinkplasData/igualdade.jpeg

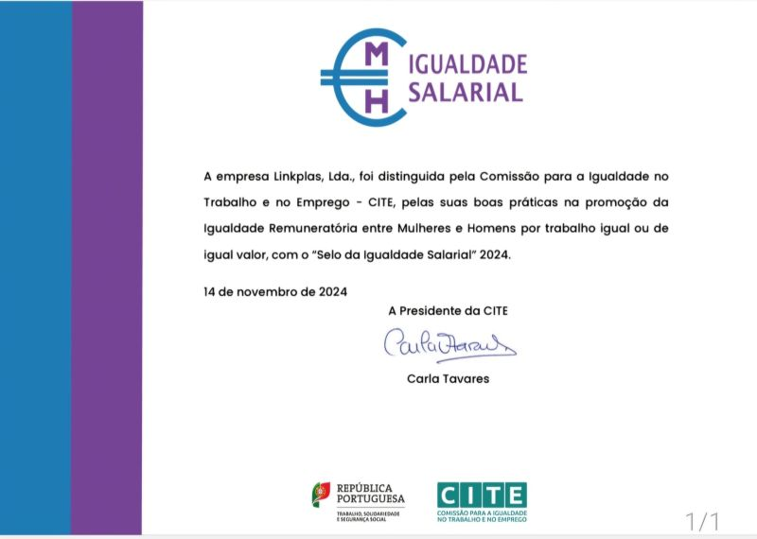
public/LinkplasData/igualdade.jpeg
