RochaDotPng/ProjectLinkplas/public/LinkplasData/image.jpg

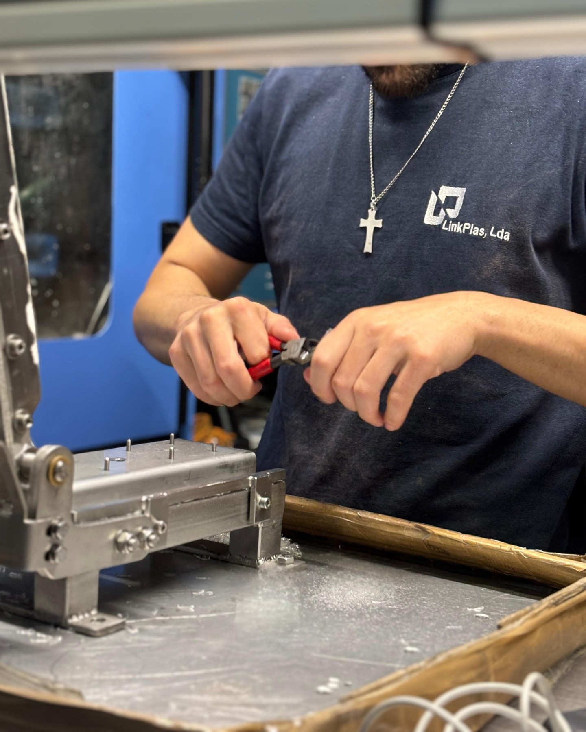
public/LinkplasData/image.jpg
