RochaDotPng/ProjectLinkplas/public/LinkplasData/natal.jpeg

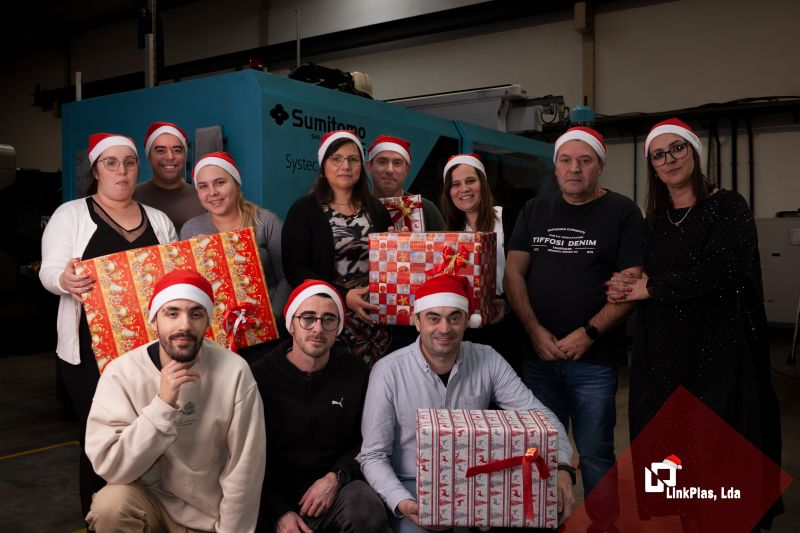
public/LinkplasData/natal.jpeg
