RochaDotPng/ProjectLinkplas/public/LinkplasData/newyear.jpg

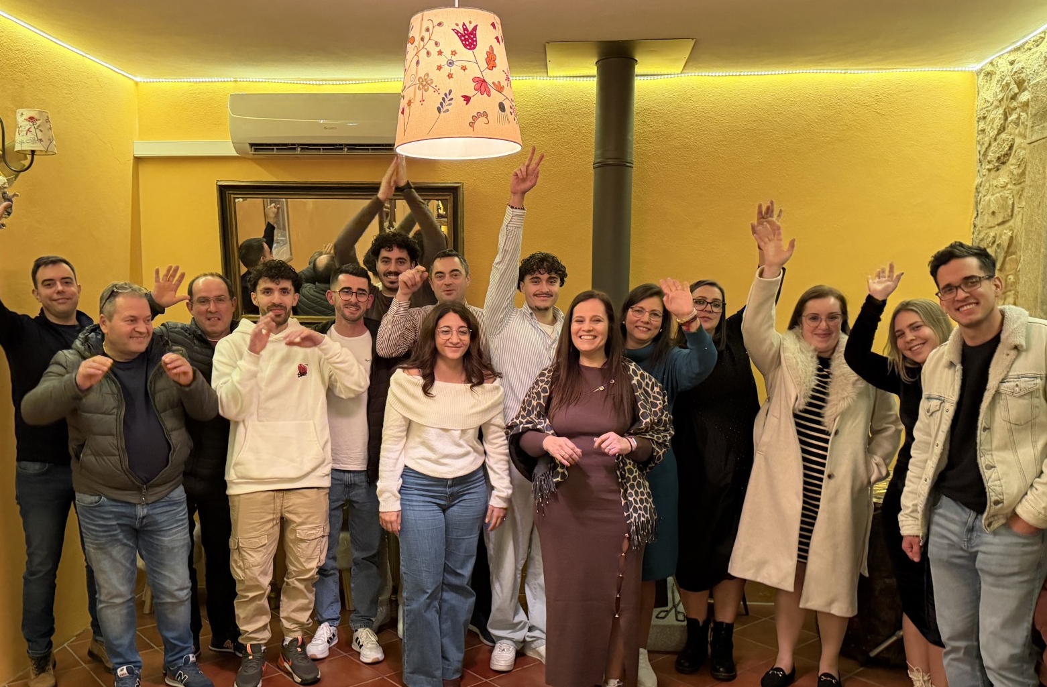
public/LinkplasData/newyear.jpg
