RochaDotPng/ProjectLinkplas/public/LinkplasData/organizacao.jpeg

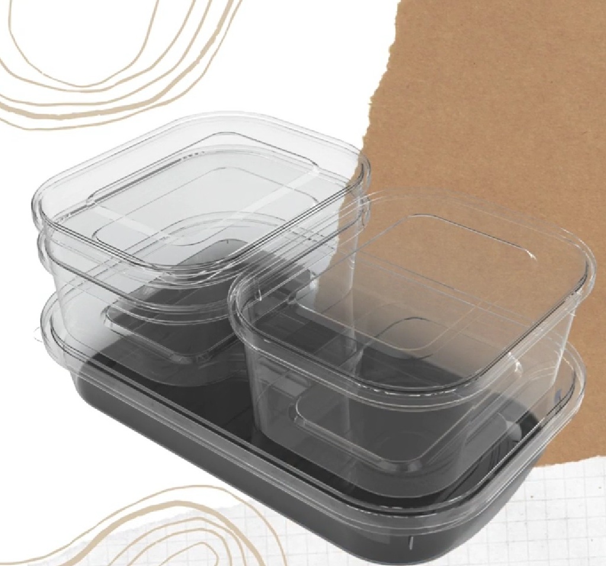
public/LinkplasData/organizacao.jpeg
