RochaDotPng/ProjectLinkplas/public/LinkplasData/rabanada.jpeg

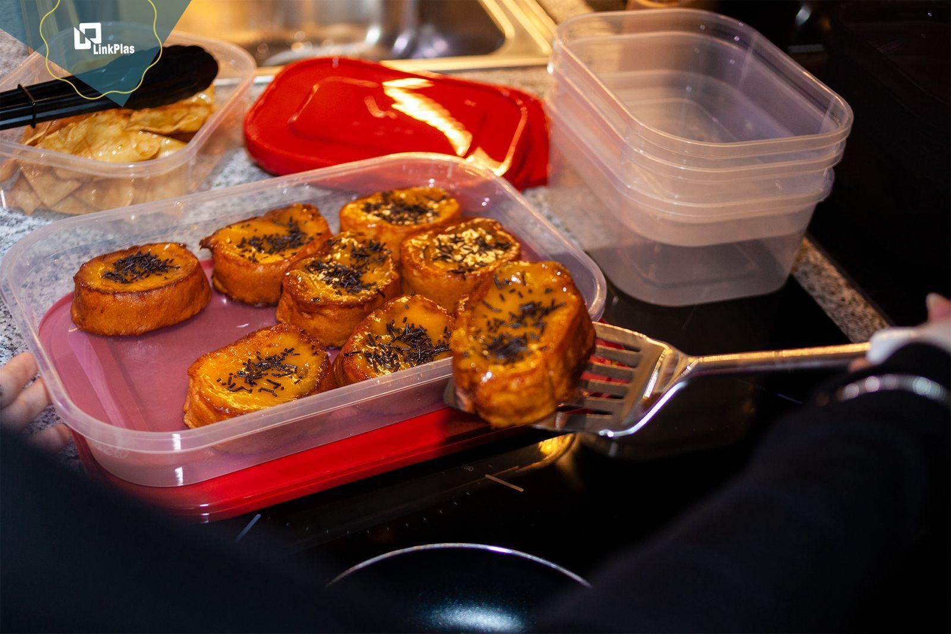
public/LinkplasData/rabanada.jpeg
