RochaDotPng/ProjectLinkplas/content-inbox/3d/2500ML - 8000000349 tampa2540 keepylink -1.STL

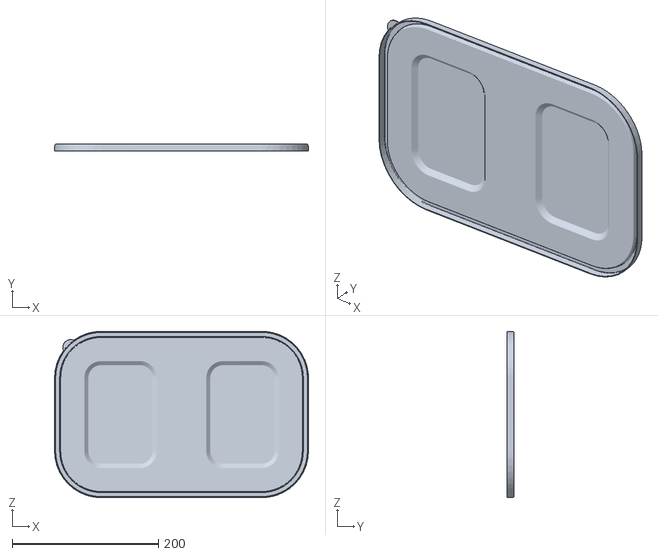
[picture p59: CAD file, 2026-10-02]
content-inbox/3d/2500ML - 8000000349 tampa2540 keepylink -1.STL
347.9 x 9.05 x 227.9
