RochaDotPng/ProjectLinkplas/content-inbox/3d/2500ML - 7017020007 base keepylink2500ml-1.STL

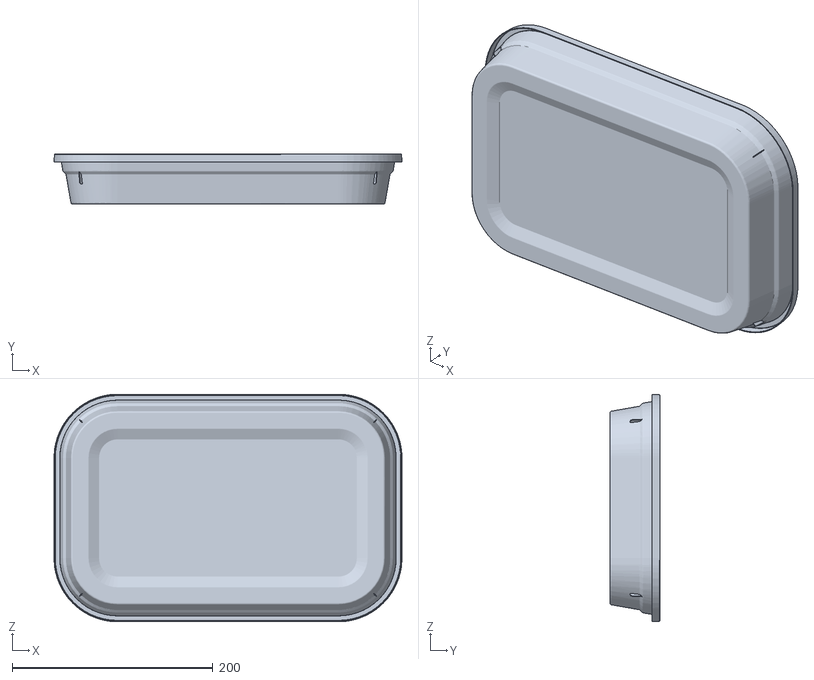
[picture p60: CAD file, 2026-10-02]
content-inbox/3d/2500ML - 7017020007 base keepylink2500ml-1.STL
346.5 x 50.0 x 226.5
