RochaDotPng/ProjectLinkplas/content-inbox/3d/1000ML - 8000000340 tampa 05101520 keepylink -1.STL

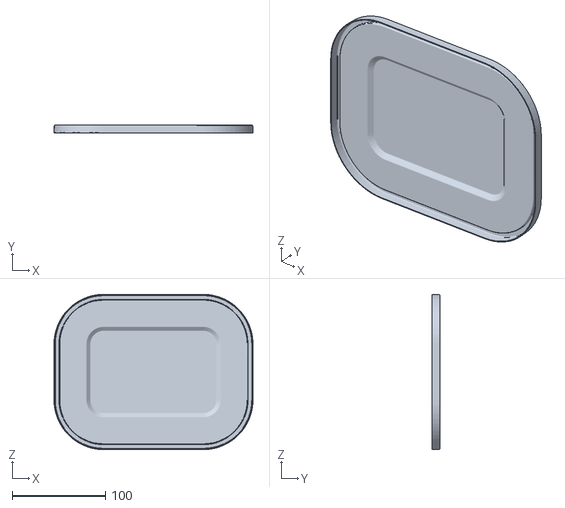
[picture p61: CAD file, 2026-10-02]
content-inbox/3d/1000ML - 8000000340 tampa 05101520 keepylink -1.STL
213.9 x 8.70 x 166.9
