RochaDotPng/ProjectLinkplas/content-inbox/3d/1000ML - 7017020003 base keepylink1000ml -1.STL

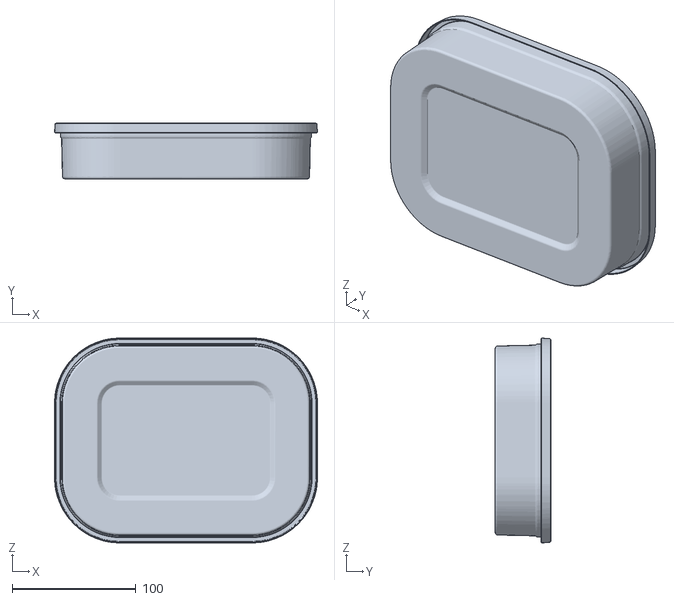
[picture p62: CAD file, 2026-10-02]
content-inbox/3d/1000ML - 7017020003 base keepylink1000ml -1.STL
212.8 x 45.0 x 165.8
