RochaDotPng/ProjectLinkplas/content-inbox/3d/4000ML - base keepylink4000ml-1.STL

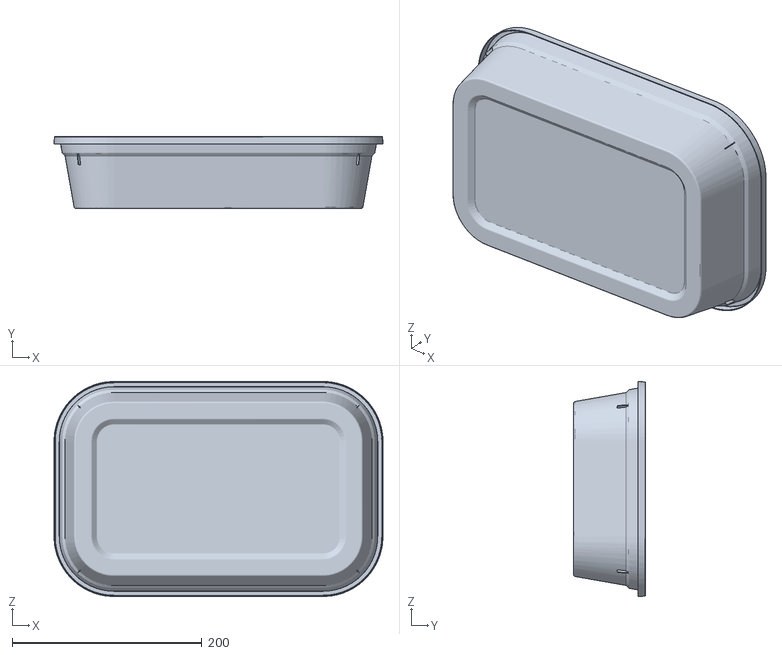
[picture p63: CAD file, 2026-10-02]
content-inbox/3d/4000ML - base keepylink4000ml-1.STL
346.4 x 76.0 x 226.4
