RochaDotPng/ProjectLinkplas/content-inbox/3d/caixa grande.STL

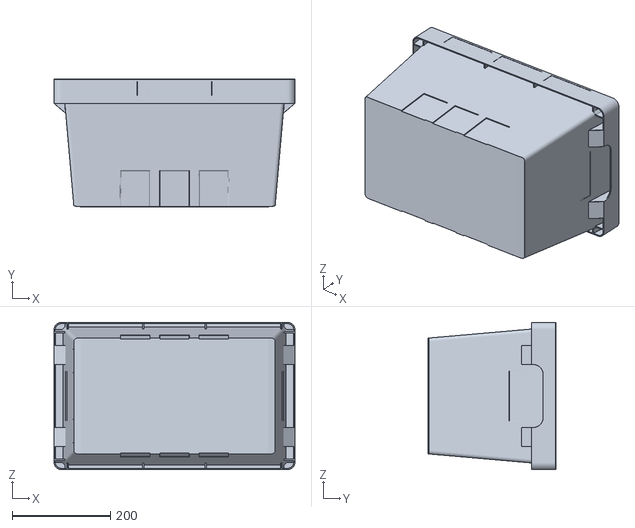
[picture p64: CAD file, 2026-10-02]
content-inbox/3d/caixa grande.STL
491.0 x 260.0 x 300.0
