RochaDotPng/ProjectLinkplas/content-inbox/3d/500ML - 7017020002 base keepylink500ml -1.STL

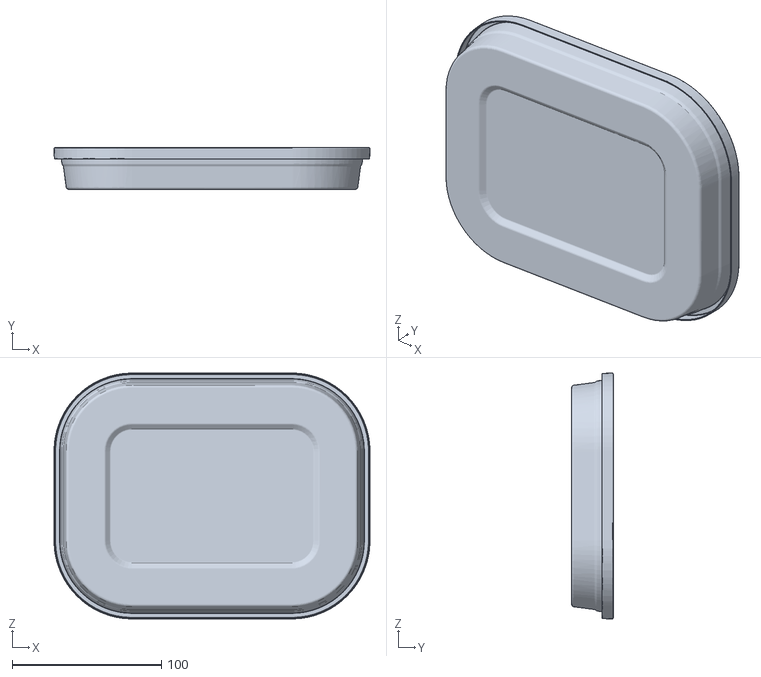
[picture p65: CAD file, 2026-10-02]
content-inbox/3d/500ML - 7017020002 base keepylink500ml -1.STL
211.9 x 28.0 x 164.9
