RochaDotPng/ProjectLinkplas/content-inbox/3d/caixa pequena.STL

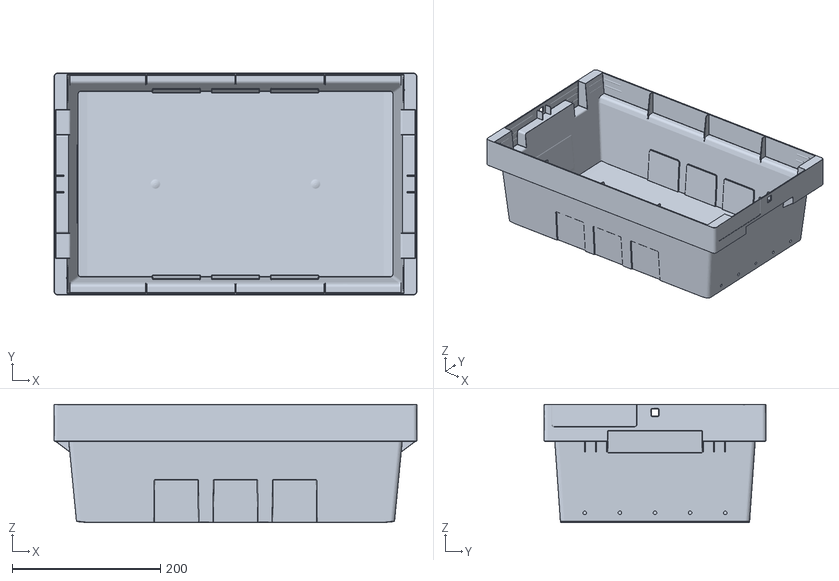
[picture p66: CAD file, 2026-10-02]
content-inbox/3d/caixa pequena.STL
490.5 x 299.7 x 159.8
