RochaDotPng/ProjectLinkplas/content-inbox/3d/tampa cx med.STL

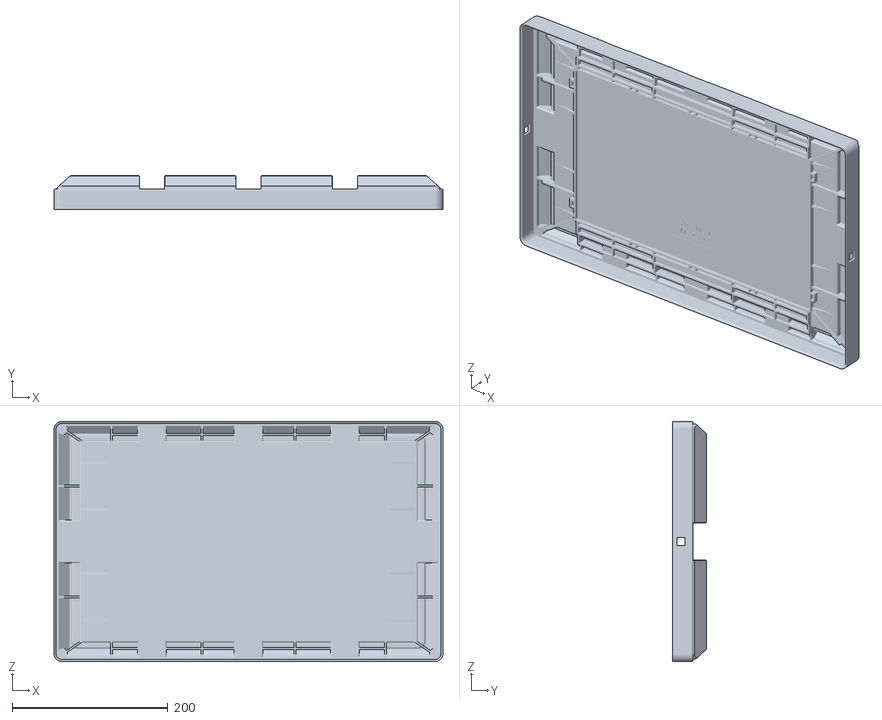
[picture p67: CAD file, 2026-10-02]
content-inbox/3d/tampa cx med.STL
499.0 x 43.0 x 308.0
