RochaDotPng/ProjectLinkplas/content-inbox/3d/1500ML. - 7017020004 base keepylink 1500ml-1.STL

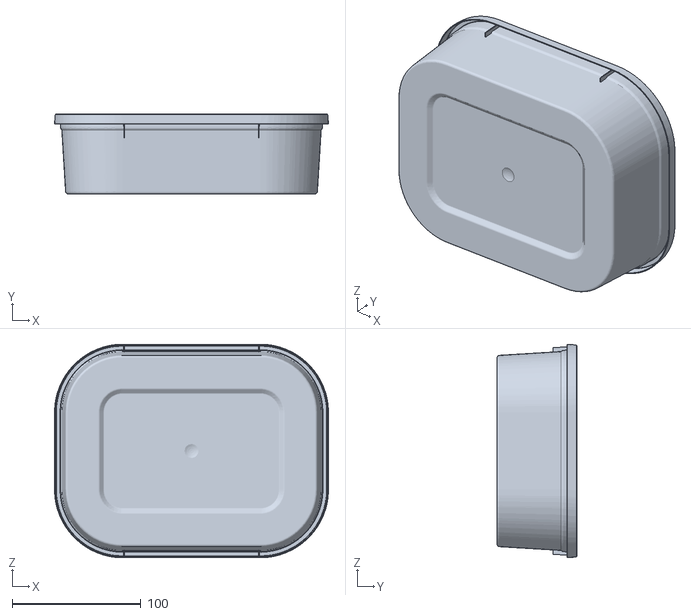
[picture p68: CAD file, 2026-10-02]
content-inbox/3d/1500ML. - 7017020004 base keepylink 1500ml-1.STL
212.8 x 62.0 x 165.8
