RochaDotPng/ProjectLinkplas/content-inbox/3d/caixa média.STL

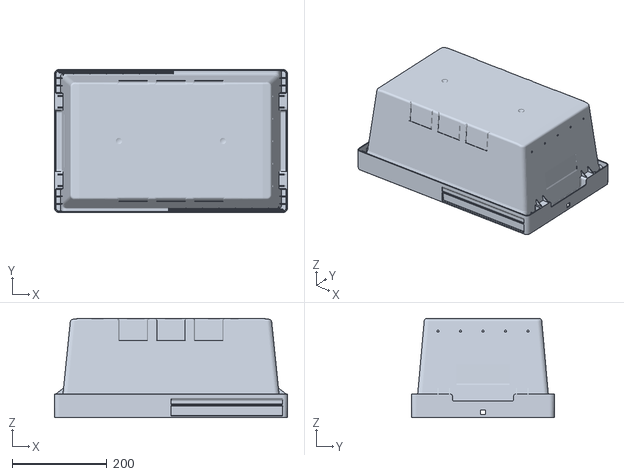
[picture p69: CAD file, 2026-10-02]
content-inbox/3d/caixa média.STL
493.2 x 302.7 x 210.0
