RochaDotPng/ProjectLinkplas/content-inbox/3d/7017030015.stl

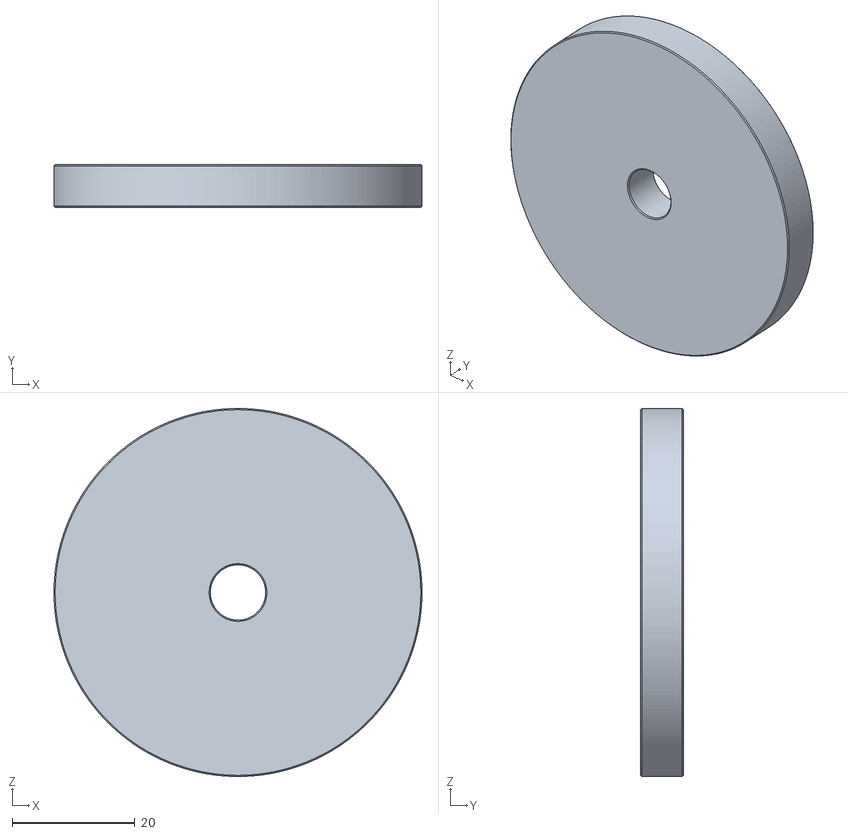
[picture p70: CAD file, 2026-10-03]
content-inbox/3d/7017030015.stl
60.0 x 7.00 x 60.0
