RochaDotPng/ProjectLinkplas/public/files/Abracadeira/7017030008.STEP

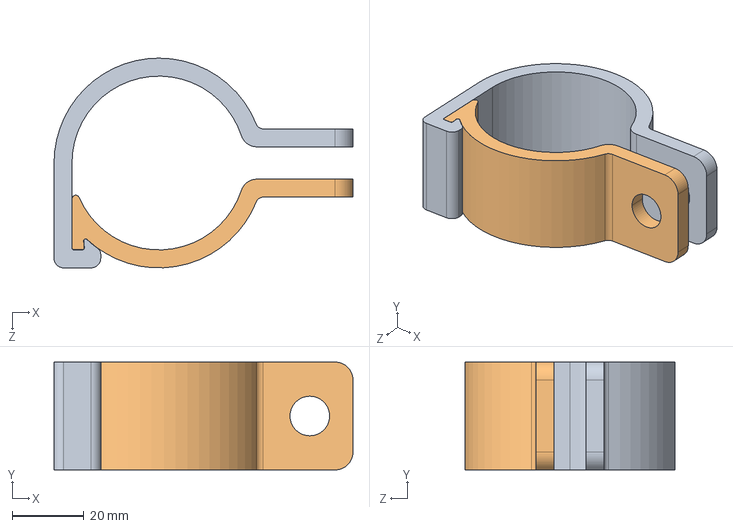
[picture p71: CAD file, 2024-03-07]
public/files/Abracadeira/7017030008.STEP
83.1 x 30.0 x 58.3 mm
