RochaDotPng/ProjectLinkplas/public/files/Anilha/7017030014.STEP

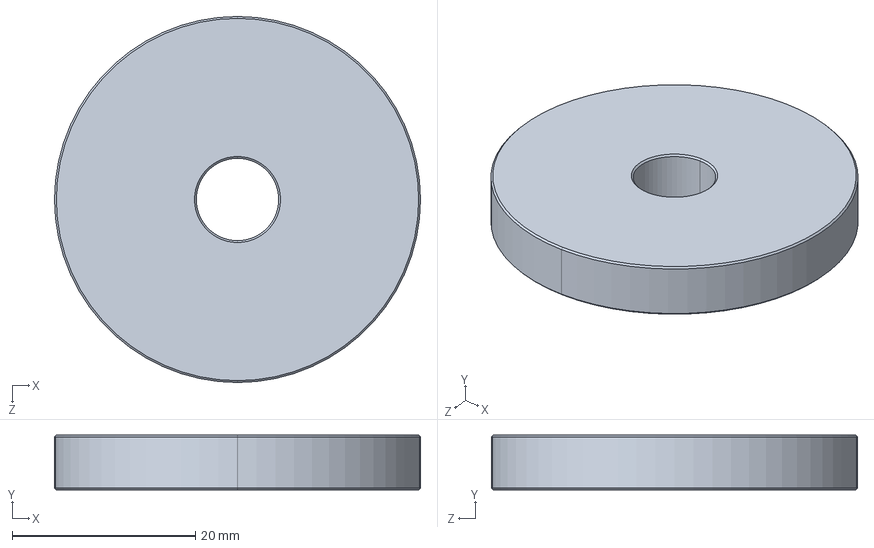
[picture p72: CAD file, 2025-02-15]
public/files/Anilha/7017030014.STEP
40.0 x 6.00 x 40.0 mm
