RochaDotPng/ProjectLinkplas/public/files/Intercalar/7017030013.STEP

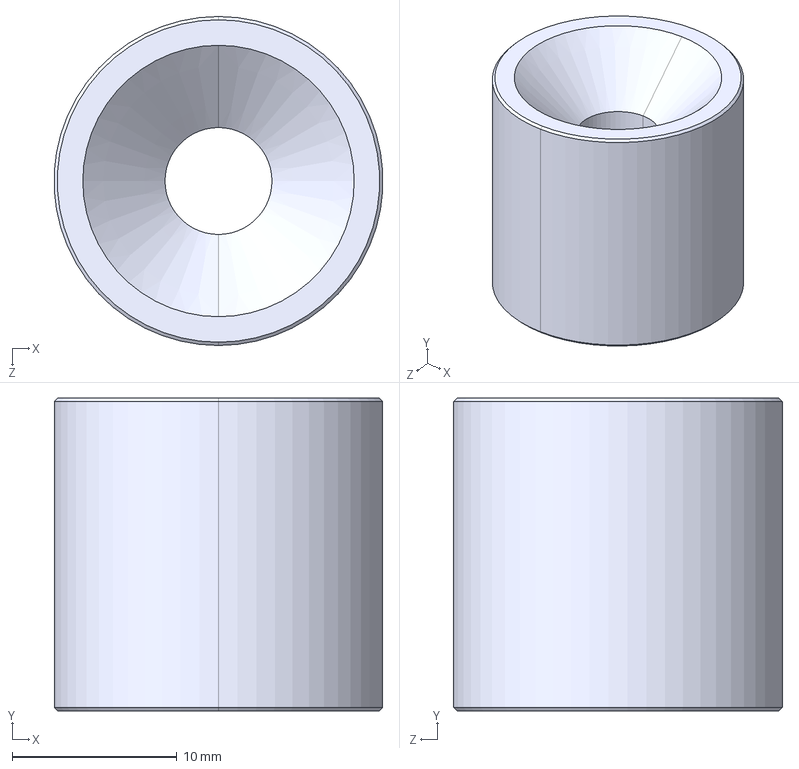
[picture p73: CAD file, 2024-03-07]
public/files/Intercalar/7017030013.STEP
20.0 x 19.0 x 20.0 mm
