RochaDotPng/ProjectLinkplas/(list of files, cad)

Other CAD files:
content-inbox/3d/4000ML - 8000000349 tampa2540 keepylink -1.STL
content-inbox/3d/1500ML. - 8000000340 tampa 05101520 keepylink -1.STL
content-inbox/3d/500ML - 8000000340 tampa 05101520 keepylink -1.STL
content-inbox/3d/7017030008.stl
content-inbox/3d/7017030011.stl
content-inbox/3d/7017030013.stl
public/files/Abracadeira/7017030008.DWG
public/files/Abracadeira/7017030008.IGS
public/files/Abracadeira/7017030008.SLDPRT
public/files/Anilha/7017030014.IGS
public/files/Anilha/7017030014.SLDPRT
public/files/Anilha/7017030015.IGS
public/files/Anilha/7017030015.SLDPRT
public/files/Anilha/7017030015.STEP
public/files/Anilha/7017030016.IGS
public/files/Anilha/7017030016.STEP
public/files/Intercalar/7017030013.DWG
public/files/Intercalar/7017030013.IGS
public/files/Intercalar/7017030013.SLDPRT
public/files/Tampa/7017030005.DWG
public/files/Tampa/7017030005.IGS
public/files/Tampa/7017030005.SLDPRT
public/files/Tampa/7017030005.STEP
public/files/TampaVeio/7017030009.DWG
public/files/TampaVeio/7017030009.IGS
public/files/TampaVeio/7017030009.SLDPRT
public/files/TampaVeio/7017030009.STEP
public/files/TampaVeio/7017030011.DWG
public/files/TampaVeio/7017030011.IGS
public/files/TampaVeio/7017030011.SLDPRT
public/files/TampaVeio/7017030011.STEP
