RochaDotPng/ProjectLinkplas/docs/brand/manual-normas-graficas-2026.pdf

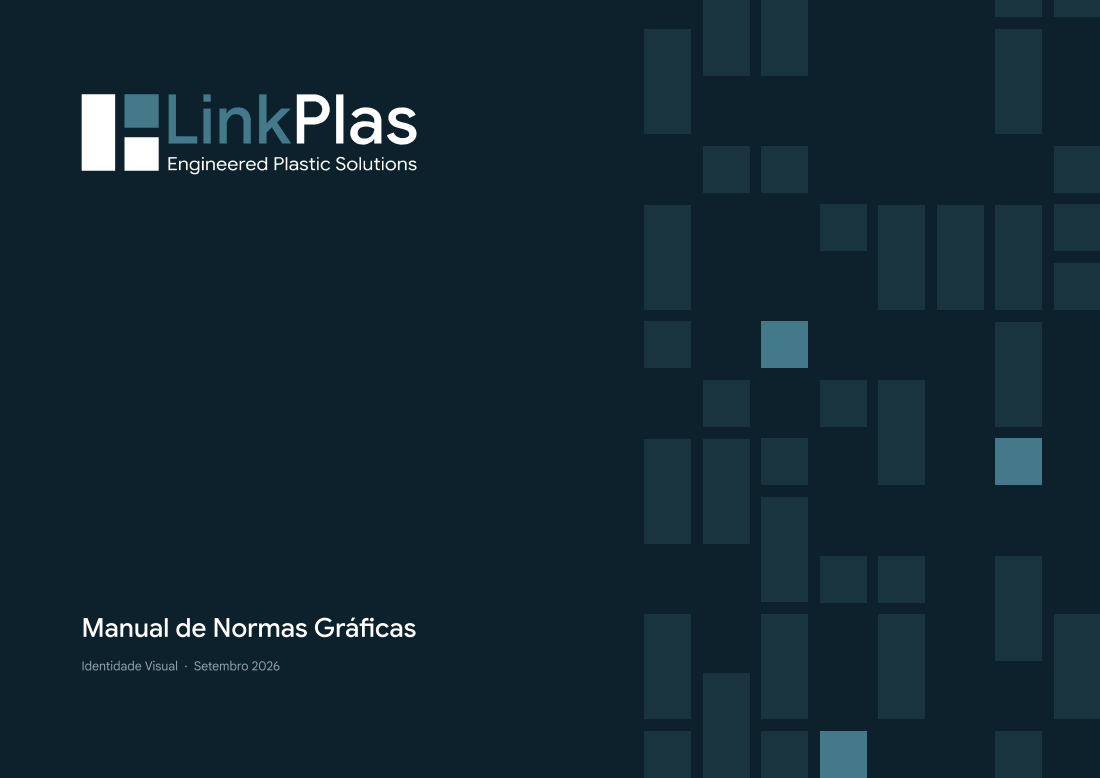
[picture p74: page 1]

Manual de Normas Gráficas

Identidade Visual · Setembro 2026

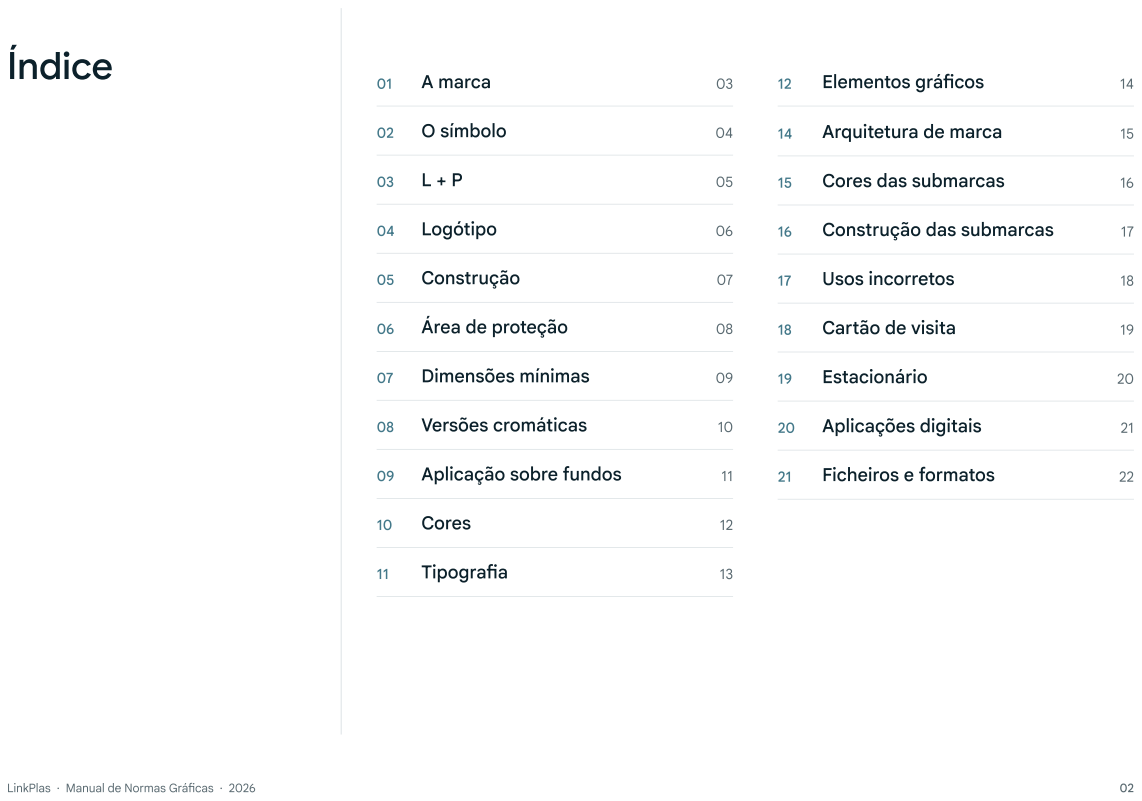
[picture p75: page 2]
Índice; A marca; O símbolo; Logótipo; Construção; Área de proteção; Dimensões mínimas; Versões cromáticas; Aplicação sobre fundos; Cores; Tipografia; Elementos gráficos; Arquitetura de marca; Cores das submarcas; Construção das submarcas; Usos incorretos; Cartão de visita; Estacionário; Aplicações digitais; Ficheiros e formatos; LinkPlas · Manual de Normas Gráficas · 2026

01

# A marca

Quem somos e o que a identidade

deve comunicar.

# Engineered Plastic Solutions

A LinkPlas desenvolve soluções em plástico com base técnica e rigor industrial. A

identidade visual traduz essa postura: formas geométricas, construção modular e

uma paleta sóbria que transmite precisão, confiança e solidez.

Este manual reúne as regras de utilização do logótipo, cores, tipografia e arquitetura de marca,

para garantir uma aplicação consistente em todos os suportes: impressos, digitais, embalagem e

sinalética. Sempre que surgir uma situação não prevista, deve seguir-se o espírito destas normas e

privilegiar a clareza e a legibilidade.

### Precisão

Engenharia e rigor técnico em

cada solução.

## Ligação

Uma marca-mãe que une várias

áreas de negócio.

## Solidez

Uma presença estável, confiável

e duradoura.

02

# O símbolo

Conceito e significado do símbolo.

### O símbolo é construído a partir de três

### módulos geométricos: uma barra vertical e

### dois quadrados. Juntos, formam as iniciais L e

P de LinkPlas e sugerem peças que encaixam,

### componentes técnicos e a ideia de ligação

que dá nome à marca.

### O quadrado superior é o elemento variável do

### sistema: na marca-mãe assume o Azul

### Petróleo e, em cada submarca, a respetiva

### cor de acento. Os restantes módulos

### mantêm-se sempre na cor principal da

composição.

03
L + P

O símbolo desenha as iniciais de LinkPlas.

O símbolo é um monograma construído com

as iniciais da marca. A barra vertical com o

quadrado inferior, em Azul Profundo, forma

o L de Link; a mesma barra com o quadrado

superior, em Azul Petróleo, forma o P de

Plas.

A barra é partilhada pelas duas letras: é

literalmente o elo, o link, que as une. A

diferença de cor entre os dois quadrados é

o que permite ler as duas iniciais num único

sinal.

Nas submarcas o monograma LP mantém-

se, como assinatura do grupo; apenas o

quadrado do P muda de cor.

## L de Link

Barra + quadrado inferior em Azul Profundo

P de Plas

Barra + quadrado superior em Azul Petróleo

O símbolo

As duas letras partilham a mesma barra

L

+

P

=

LP

04

# Logótipo

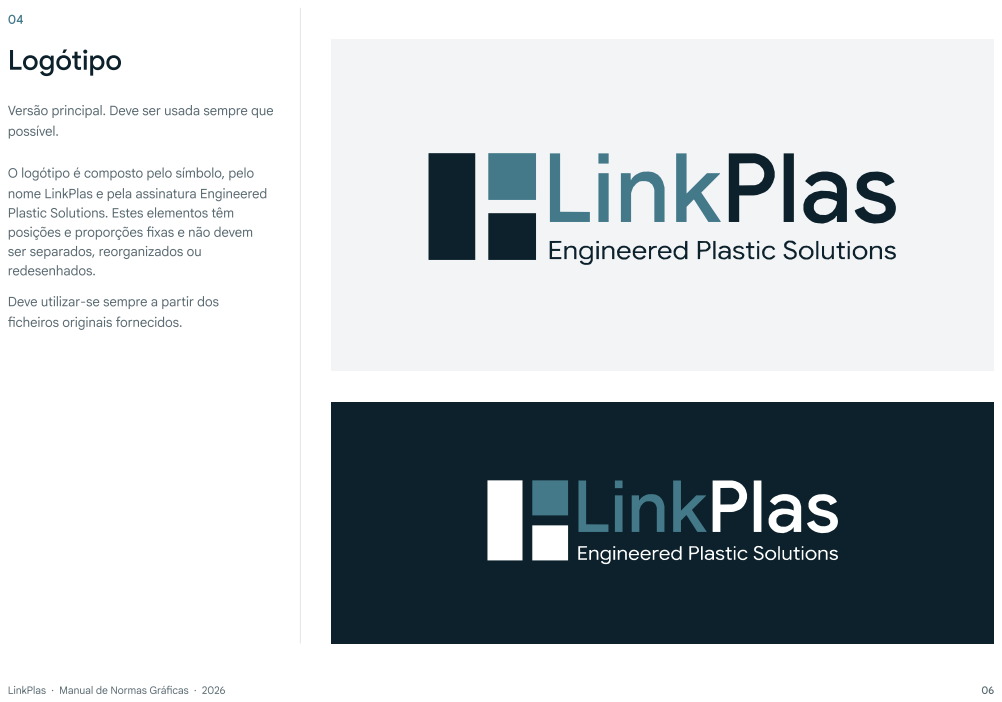
[picture p76: page 6]

Versão principal. Deve ser usada sempre que
possível.

O logótipo é composto pelo símbolo, pelo
nome LinkPlas e pela assinatura Engineered
Plastic Solutions. Estes elementos têm
posições e proporções fixas e não devem
ser separados, reorganizados ou
redesenhados.

Deve utilizar-se sempre a partir dos
ficheiros originais fornecidos.

05

# Construção

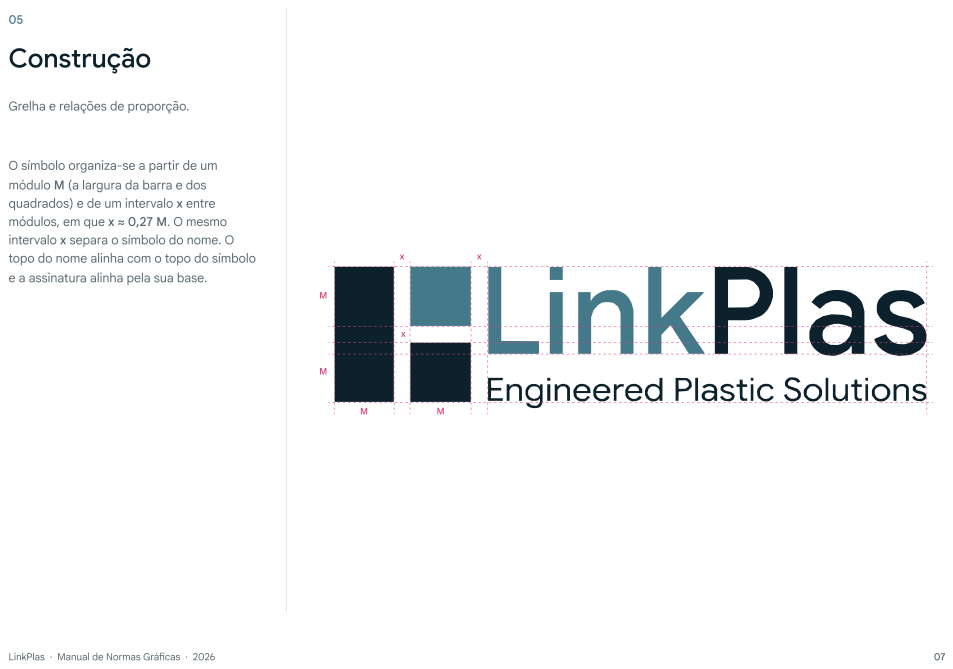
[picture p77: page 7]

Grelha e relações de proporção.

O símbolo organiza-se a partir de um
módulo M (a largura da barra e dos
quadrados) e de um intervalo x entre
módulos, em que x ≈ 0,27 M. O mesmo
intervalo x separa o símbolo do nome. O
topo do nome alinha com o topo do símbolo
e a assinatura alinha pela sua base.

06

# Área de proteção

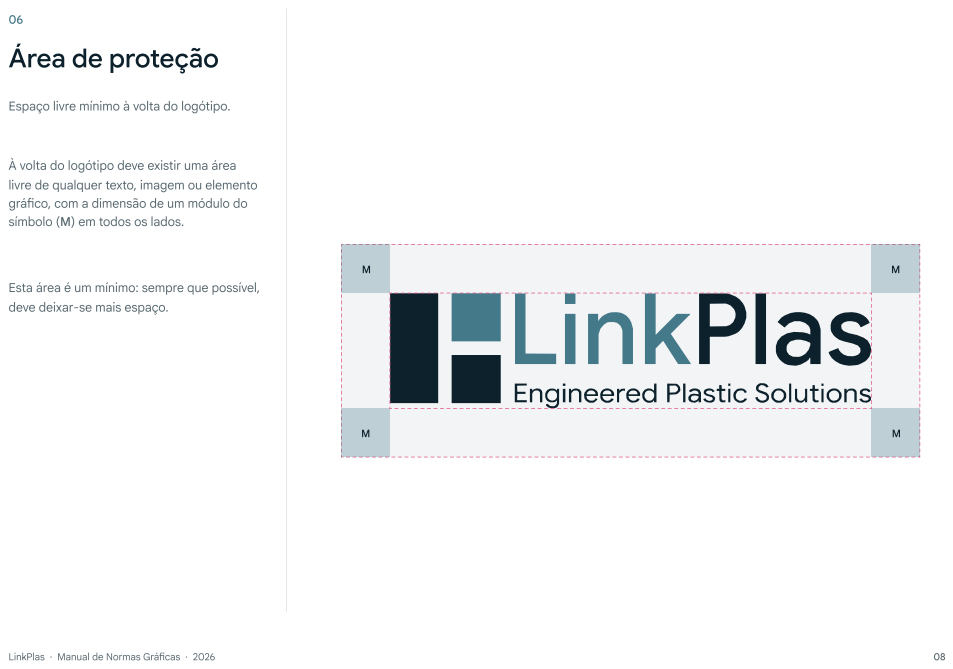
[picture p78: page 8]

Espaço livre mínimo à volta do logótipo.

À volta do logótipo deve existir uma área
livre de qualquer texto, imagem ou elemento
gráfico, com a dimensão de um módulo do
símbolo (M) em todos os lados.

Esta área é um mínimo: sempre que possível,
deve deixar-se mais espaço.

07

# Dimensões mínimas

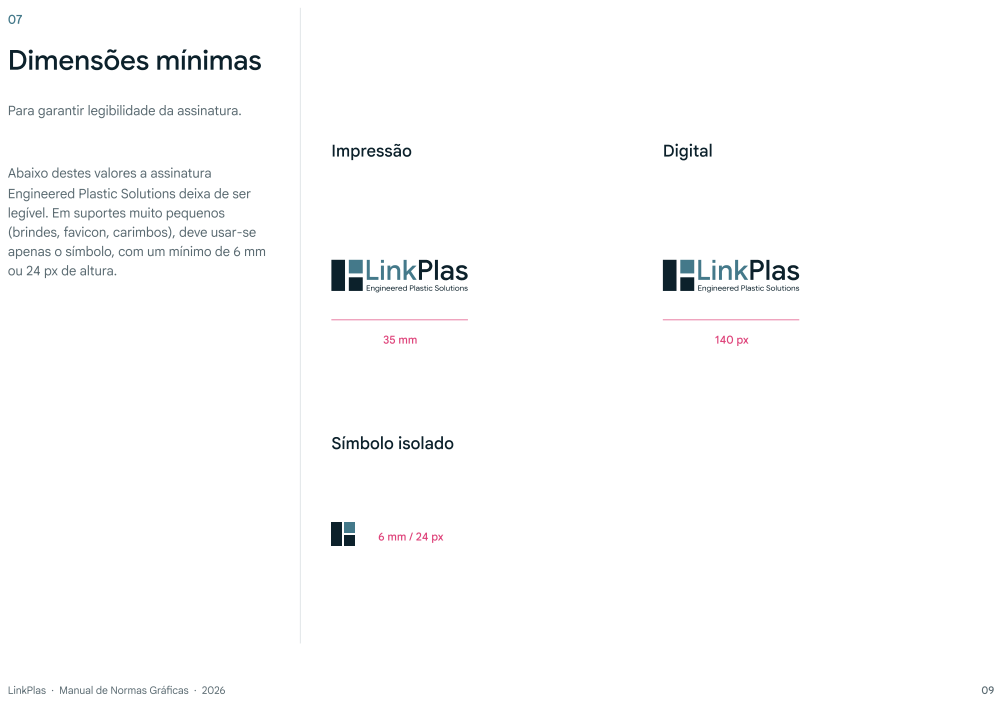
[picture p79: page 9]
Impressão; Digital; Símbolo isolado

Para garantir legibilidade da assinatura.

Abaixo destes valores a assinatura
Engineered Plastic Solutions deixa de ser
legível. Em suportes muito pequenos
(brindes, favicon, carimbos), deve usar-se

apenas o símbolo, com um mínimo de 6 mm
ou 24 px de altura.

08

# Versões cromáticas

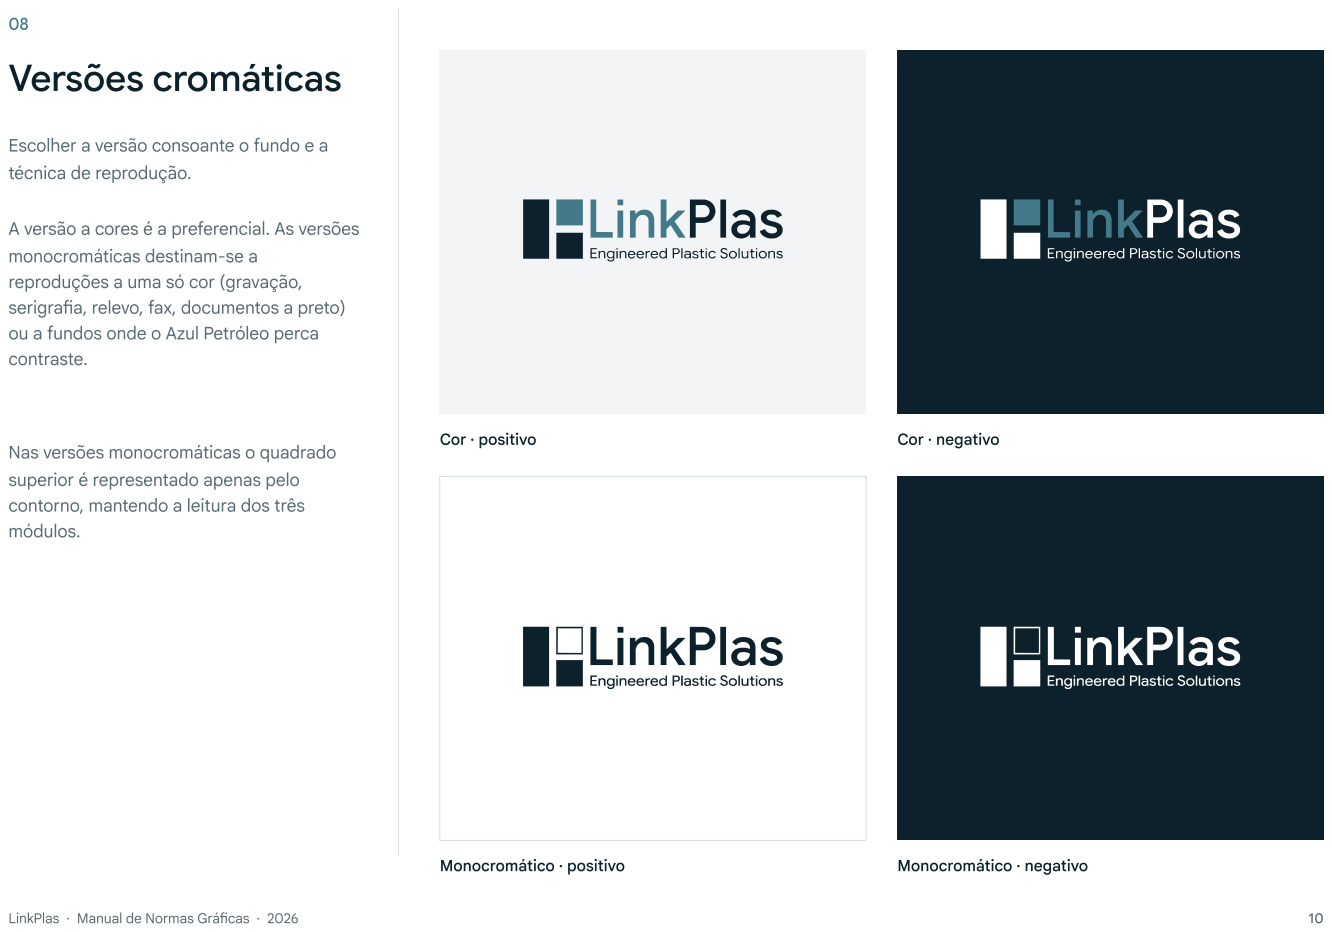
[picture p80: page 10]
contraste.; módulos.; Cor · positivo; Cor · negativo; Monocromático · positivo; Monocromático · negativo

Escolher a versão consoante o fundo e a

técnica de reprodução.

A versão a cores é a preferencial. As versões

monocromáticas destinam-se a

reproduções a uma só cor (gravação,

serigrafia, relevo, fax, documentos a preto)

ou a fundos onde o Azul Petróleo perca

Nas versões monocromáticas o quadrado

superior é representado apenas pelo

contorno, mantendo a leitura dos três

09

# Aplicação sobre fundos

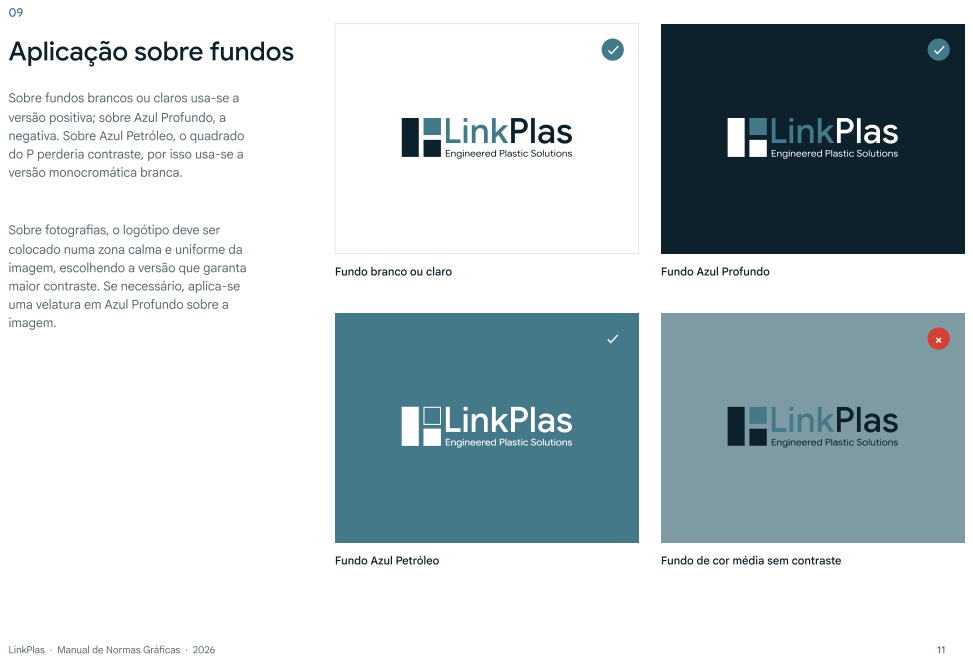
[picture p81: page 11]
Fundo Azul Petróleo; Fundo de cor média sem contraste

Sobre fundos brancos ou claros usa-se a
versão positiva; sobre Azul Profundo, a
negativa. Sobre Azul Petróleo, o quadrado
do P perderia contraste, por isso usa-se a
versão monocromática branca.

Sobre fotografias, o logótipo deve ser
colocado numa zona calma e uniforme da
imagem, escolhendo a versão que garanta
maior contraste. Se necessário, aplica-se
uma velatura em Azul Profundo sobre a
imagem.

Fundo branco ou claro

Fundo Azul Profundo

# Cores

Azul Profundo | Azul Petróleo | Branco

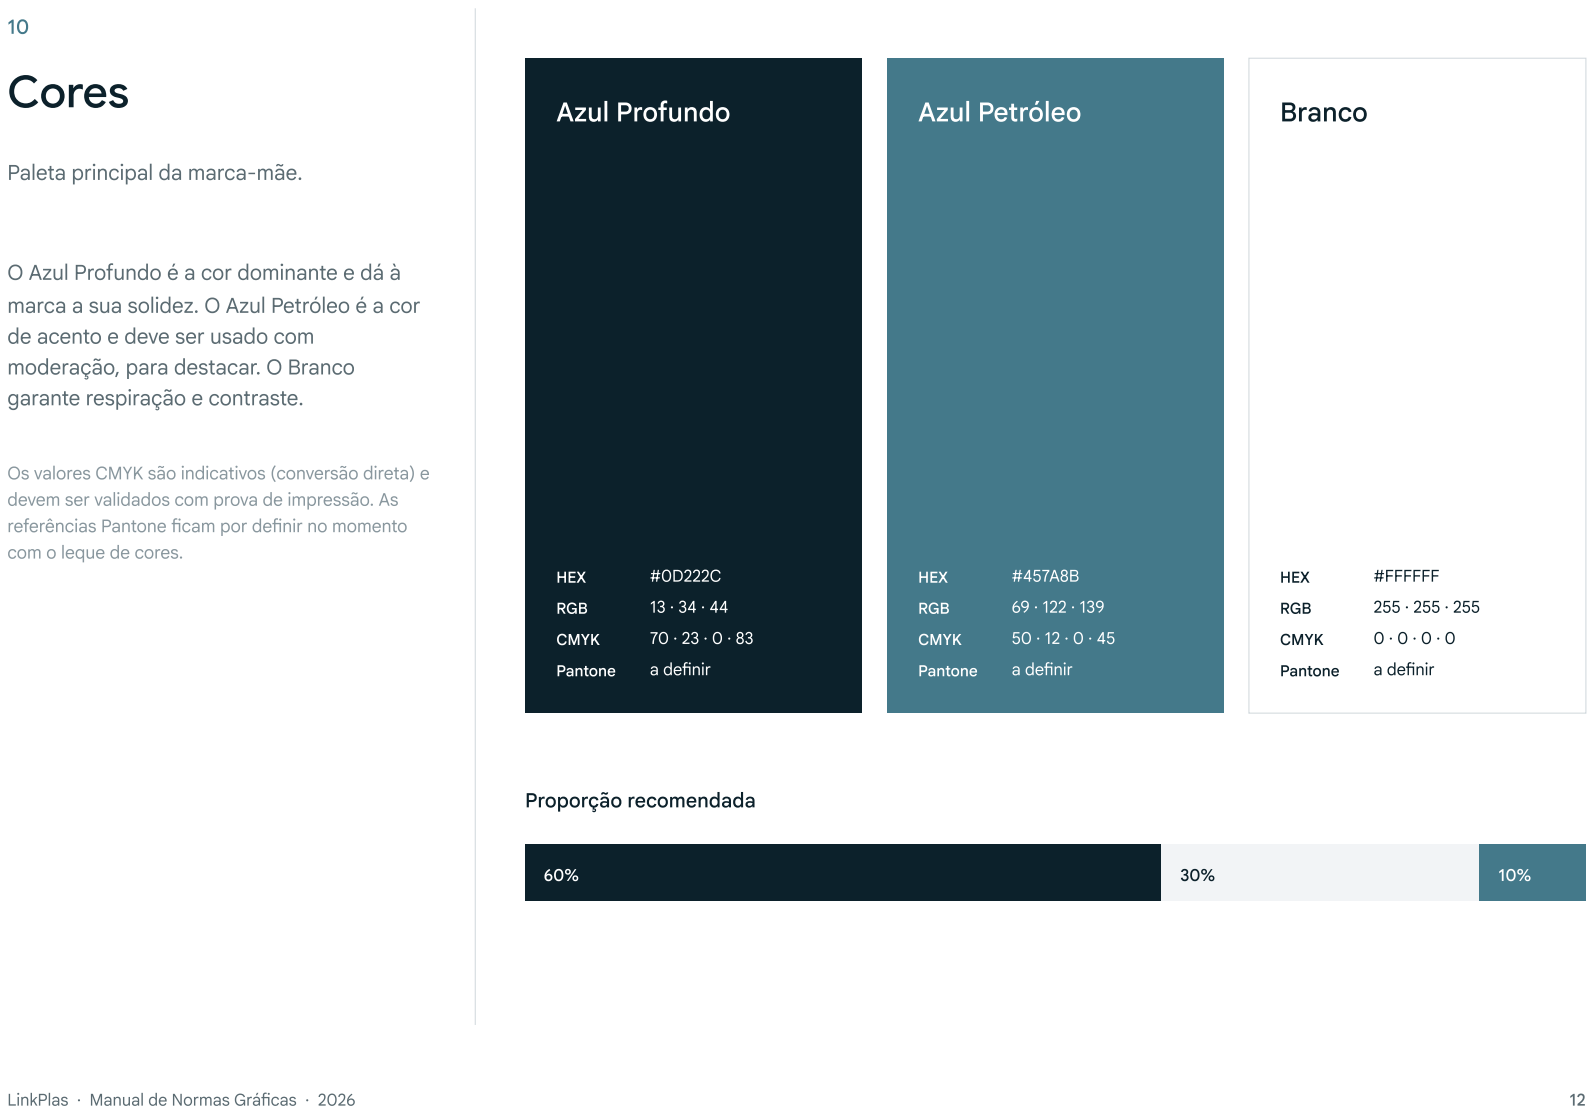
[picture p82: page 12]
HEX; RGB; CMYK; Pantone; a definir; #FFFFFF; Proporção recomendada

Paleta principal da marca-mãe.

O Azul Profundo é a cor dominante e dá à

marca a sua solidez. O Azul Petróleo é a cor

de acento e deve ser usado com

moderação, para destacar. O Branco

garante respiração e contraste.

Os valores CMYK são indicativos (conversão direta) e

devem ser validados com prova de impressão. As

referências Pantone ficam por definir no momento

com o leque de cores.

11

# Tipografia

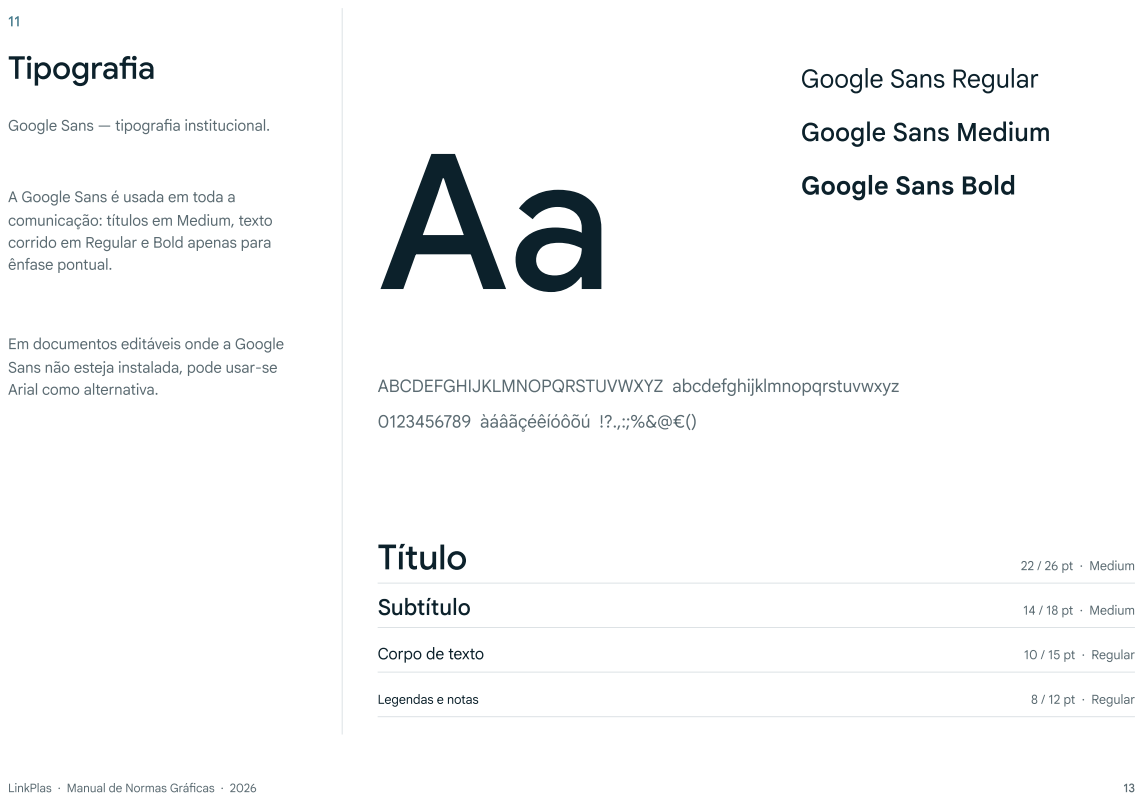
[picture p83: page 13]
ABCDEFGHIJKLMNOPQRSTUVWXYZ abcdefghijklmnopqrstuvwxyz; 0123456789 àáâãçéêíóôõú !?.,:;%&@€(); Título; Subtítulo; Legendas e notas; 22 / 26 pt · Medium; 14 / 18 pt · Medium; 10 / 15 pt · Regular; 8 / 12 pt · Regular

Google Sans Regular

Google Sans — tipografia institucional.

Google Sans Medium

Google Sans Bold

A Google Sans é usada em toda a
comunicação: títulos em Medium, texto
corrido em Regular e Bold apenas para
ênfase pontual.

Em documentos editáveis onde a Google
Sans não esteja instalada, pode usar-se

Arial como alternativa.

Corpo de texto

LinkPlas · Manual de Normas Gráficas · 2026

12

# Elementos gráficos

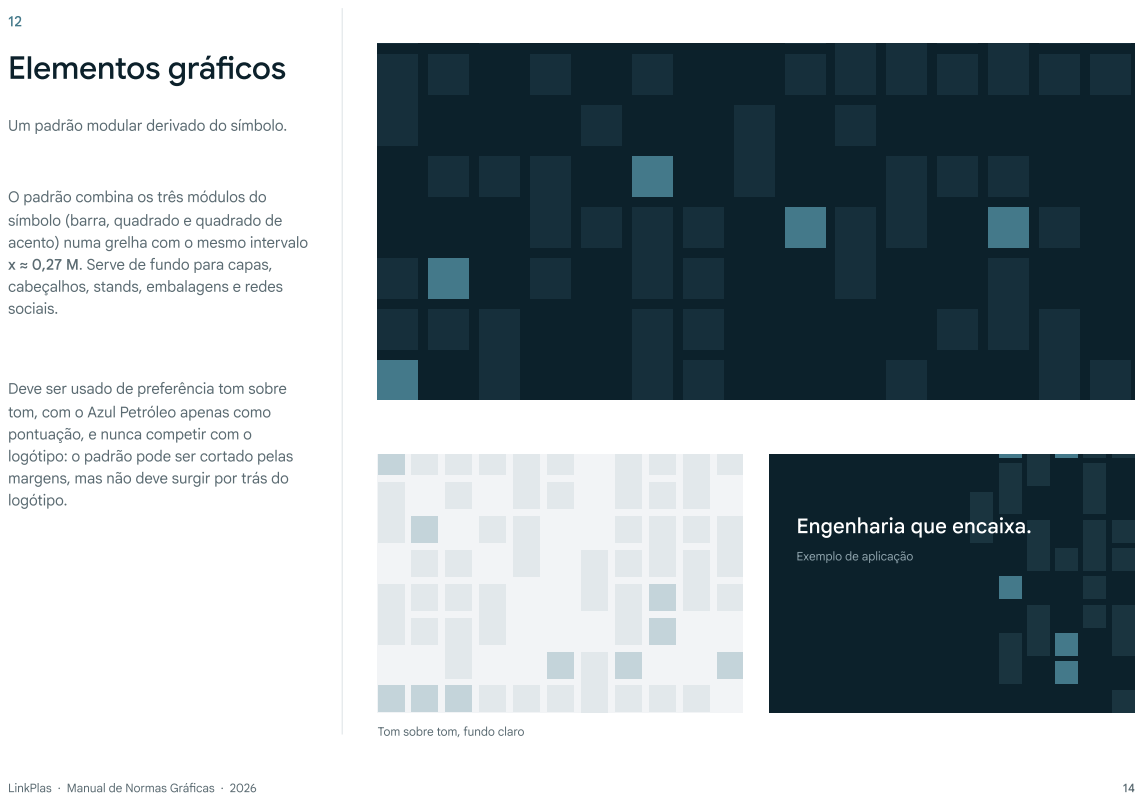
[picture p84: page 14]
sociais.

Um padrão modular derivado do símbolo.

O padrão combina os três módulos do

símbolo (barra, quadrado e quadrado de

acento) numa grelha com o mesmo intervalo

x ≈ 0,27 M. Serve de fundo para capas,

cabeçalhos, stands, embalagens e redes

Deve ser usado de preferência tom sobre

tom, com o Azul Petróleo apenas como

pontuação, e nunca competir com o

logótipo: o padrão pode ser cortado pelas

margens, mas não deve surgir por trás do
logótipo.

Engenharia que encaixa.

Exemplo de aplicação

Tom sobre tom, fundo claro

14

# Arquitetura de marca

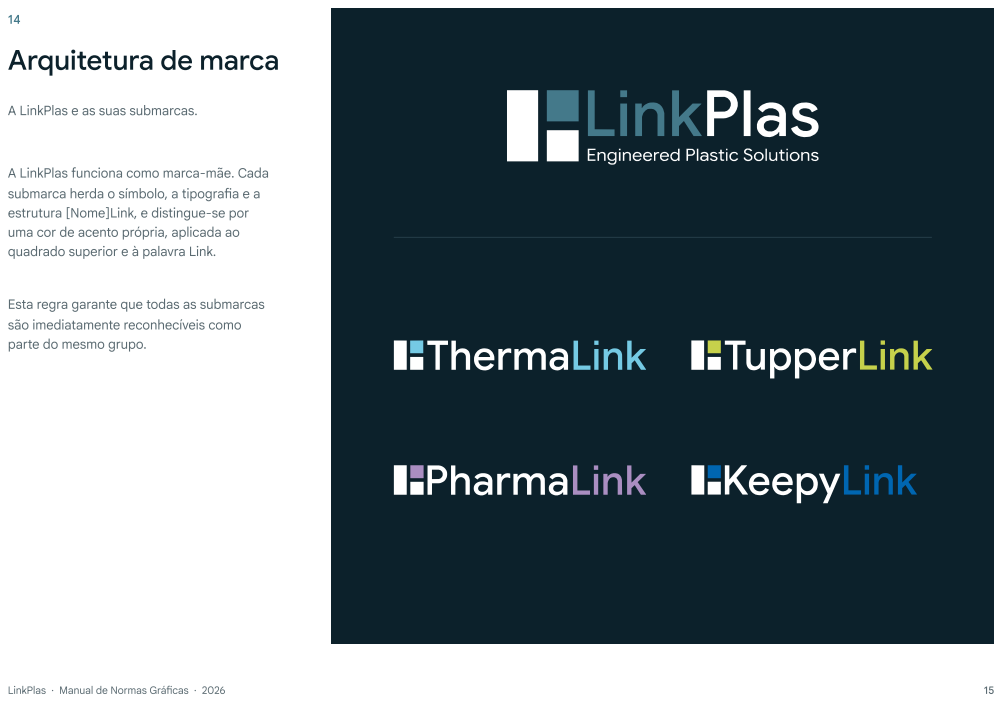
[picture p85: page 15]

A LinkPlas e as suas submarcas.

A LinkPlas funciona como marca-mãe. Cada
submarca herda o símbolo, a tipografia e a
estrutura [Nome]Link, e distingue-se por

uma cor de acento própria, aplicada ao
quadrado superior e à palavra Link.

Esta regra garante que todas as submarcas
são imediatamente reconhecíveis como
parte do mesmo grupo.

15

# Cores das submarcas

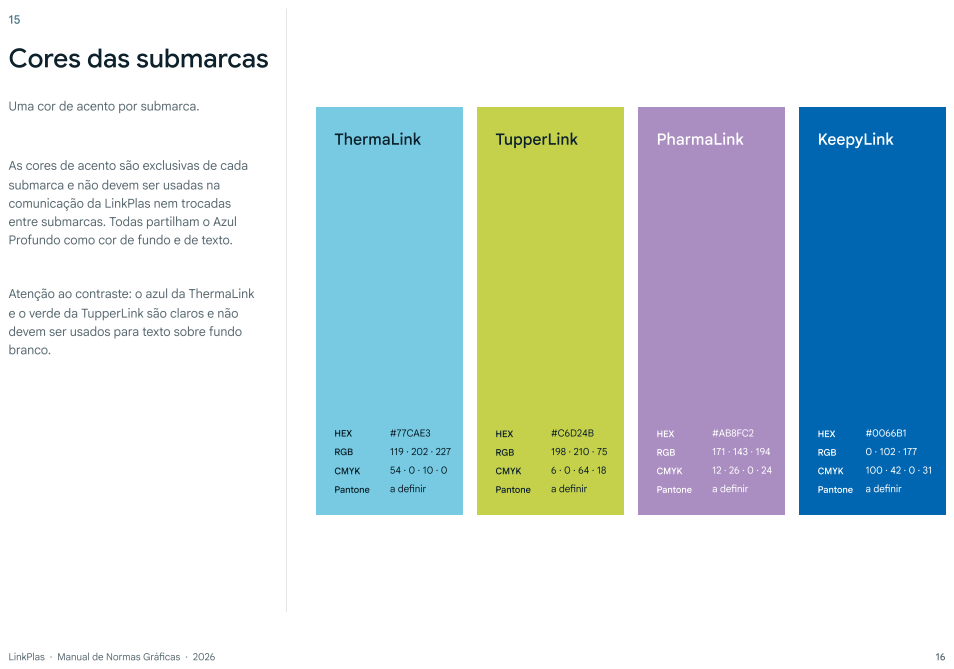
[picture p86: page 16]
ThermaLink; TupperLink; PharmaLink; KeepyLink; HEX; RGB; CMYK; Pantone; #77CAE3 119 · 202 · 227 54 · 0 · 10 · 0 a definir; #C6D24B 198 · 210 · 75 6 · 0 · 64 · 18 a definir; #AB8FC2 171 · 143 · 194 12 · 26 · 0 · 24 a definir; #0066B1 0 · 102 · 177 100 · 42 · 0 · 31 a definir

Uma cor de acento por submarca.

As cores de acento são exclusivas de cada
submarca e não devem ser usadas na
comunicação da LinkPlas nem trocadas
entre submarcas. Todas partilham o Azul
Profundo como cor de fundo e de texto.

Atenção ao contraste: o azul da ThermaLink
e o verde da TupperLink são claros e não
devem ser usados para texto sobre fundo
branco.

16

# Construção das submarcas

## Uma estrutura fixa para todas as áreas de

negócio.

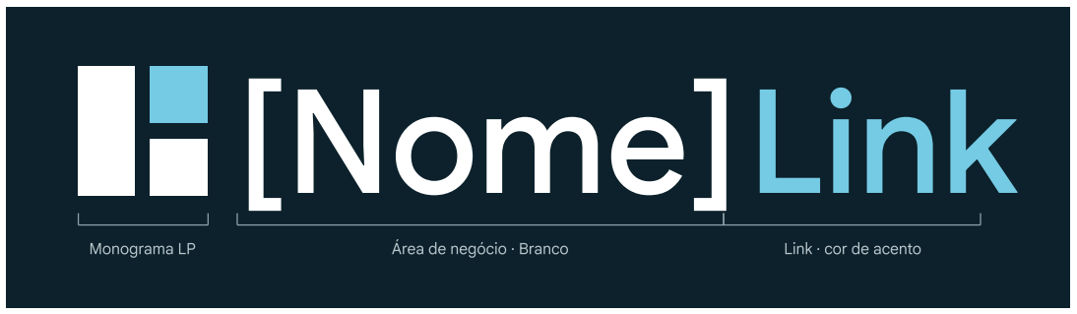
[picture p87: figure]
Monograma LP; [Nome]; Área de negócio · Branco; Link; Link · cor de acento

## As submarcas seguem sempre a mesma construção, o que torna o sistema escalável: qualquer nova área de negócio pode ser

integrada sem desenhar uma marca nova.

## Estrutura

## Monograma LP + nome da área + "Link", sem espaço

entre palavras e em Google Sans Medium.

## Endosso

## Em comunicação conjunta, a submarca surge acompanhada da LinkPlas, com o logótipo da marca-

mãe em posição secundária.

## Uma só cor de acento

## Aplicada ao quadrado do P e à palavra Link. Nunca

combinar acentos de submarcas diferentes.

## Novas submarcas

## Seguem a mesma regra e recebem uma cor de acento

nova, validada face às existentes.

# Usos incorretos

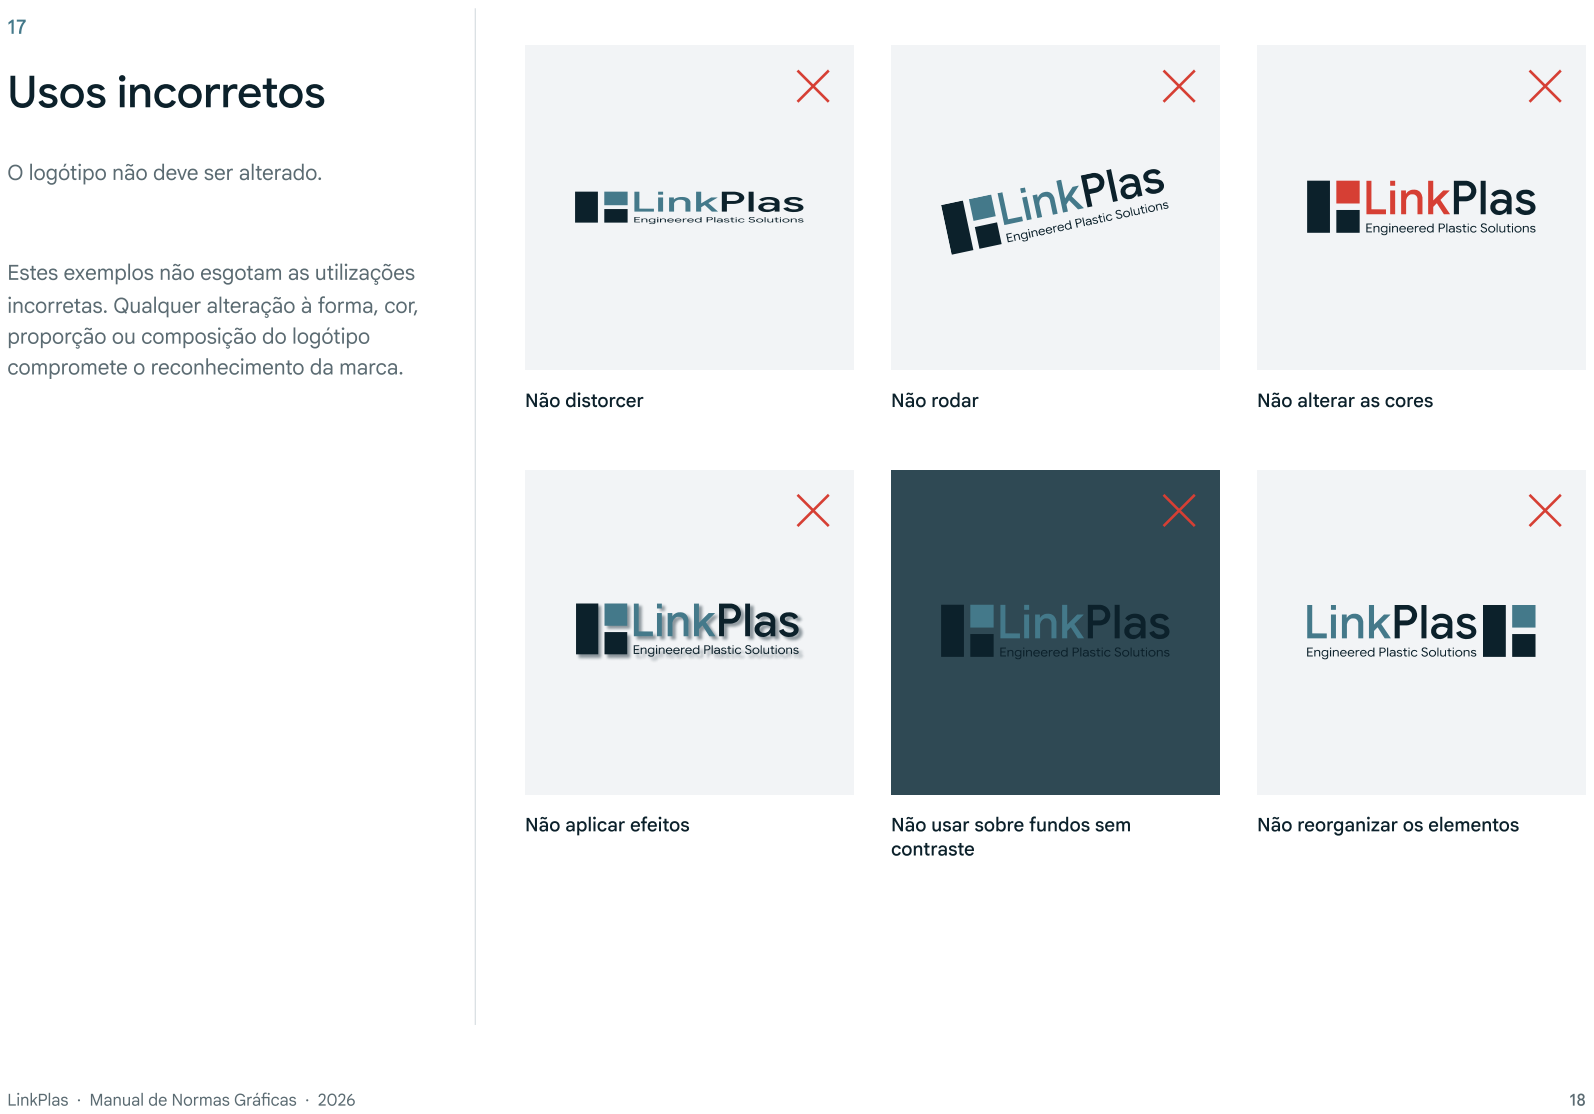
[picture p88: page 18]
Não distorcer; Não rodar; Não alterar as cores; Não aplicar efeitos; Não usar sobre fundos sem; contraste

O logótipo não deve ser alterado.

Estes exemplos não esgotam as utilizações

incorretas. Qualquer alteração à forma, cor,

proporção ou composição do logótipo

compromete o reconhecimento da marca.

Não reorganizar os elementos

# Cartão de visita

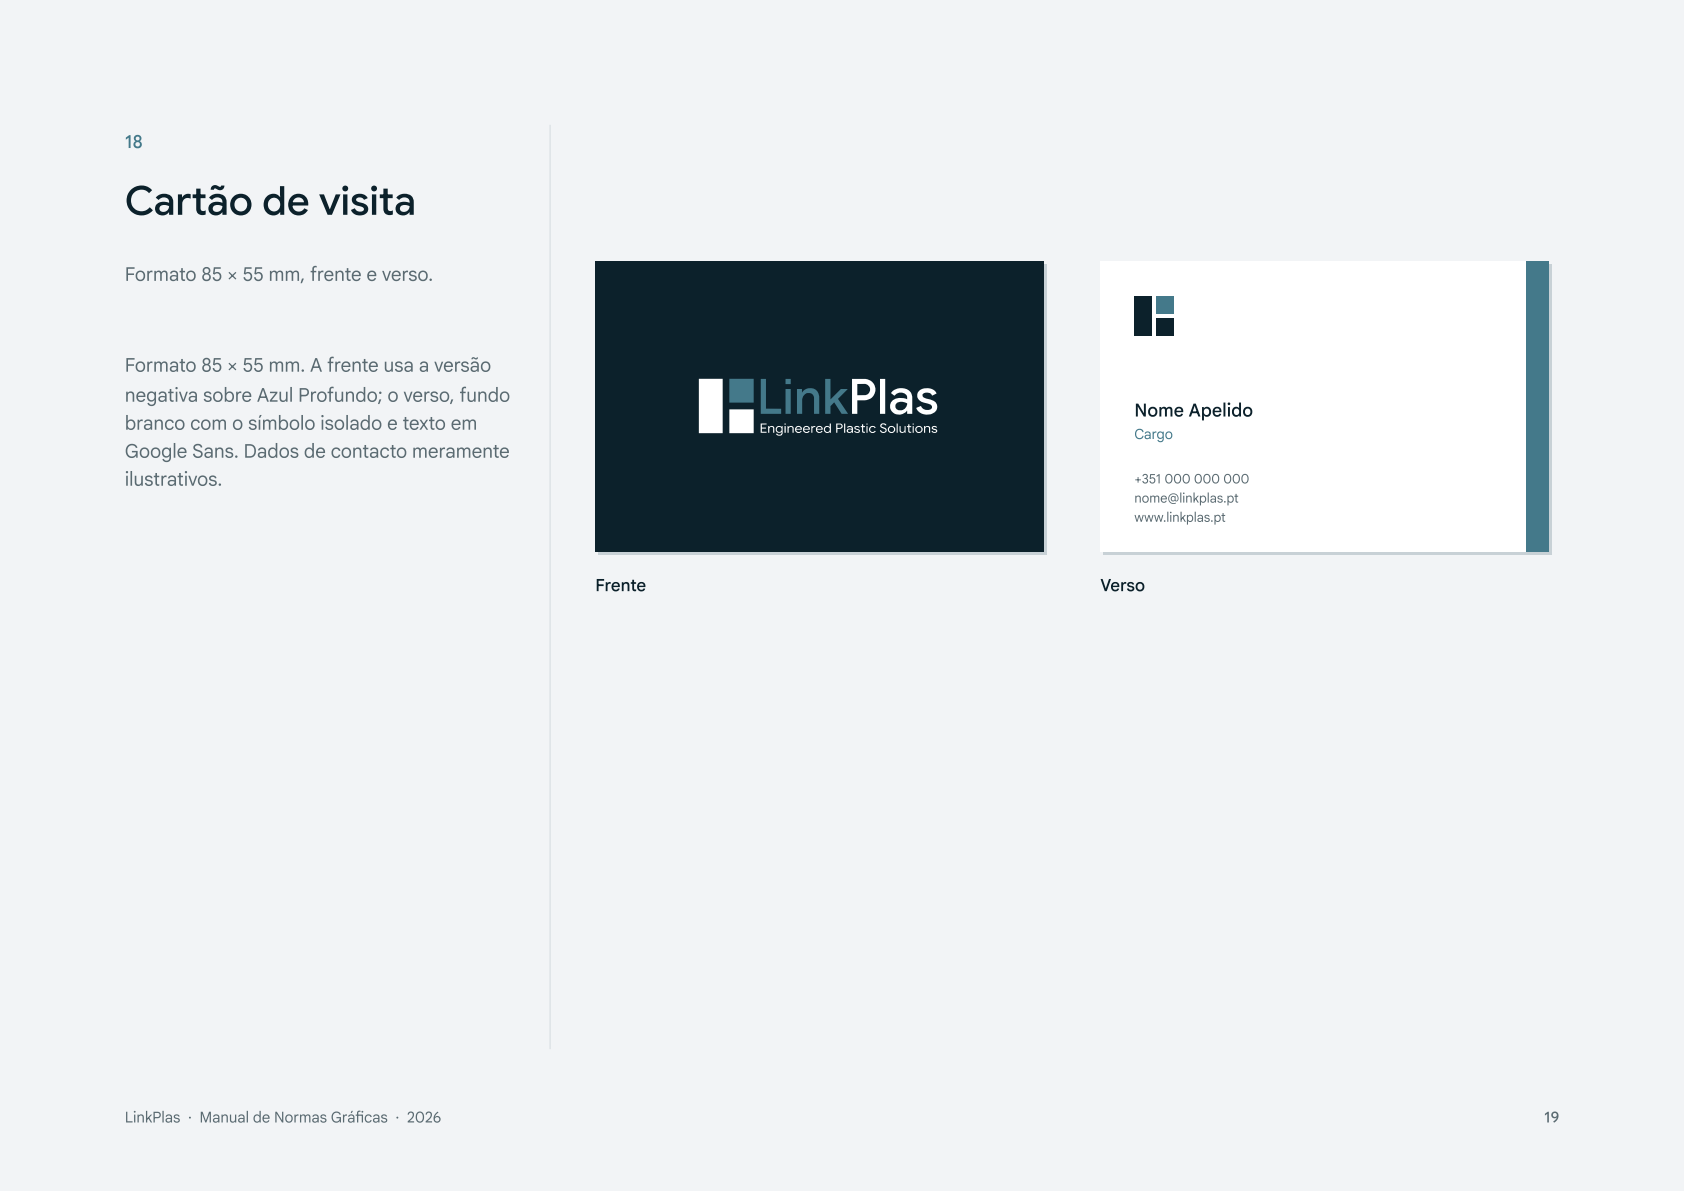
[picture p89: page 19]
ilustrativos.; Frente; Nome Apelido; Cargo; Verso

Formato 85 × 55 mm, frente e verso.

Formato 85 × 55 mm. A frente usa a versão

negativa sobre Azul Profundo; o verso, fundo

branco com o símbolo isolado e texto em

Google Sans. Dados de contacto meramente

nome@linkplas.pt

www.linkplas.pt

# Estacionário

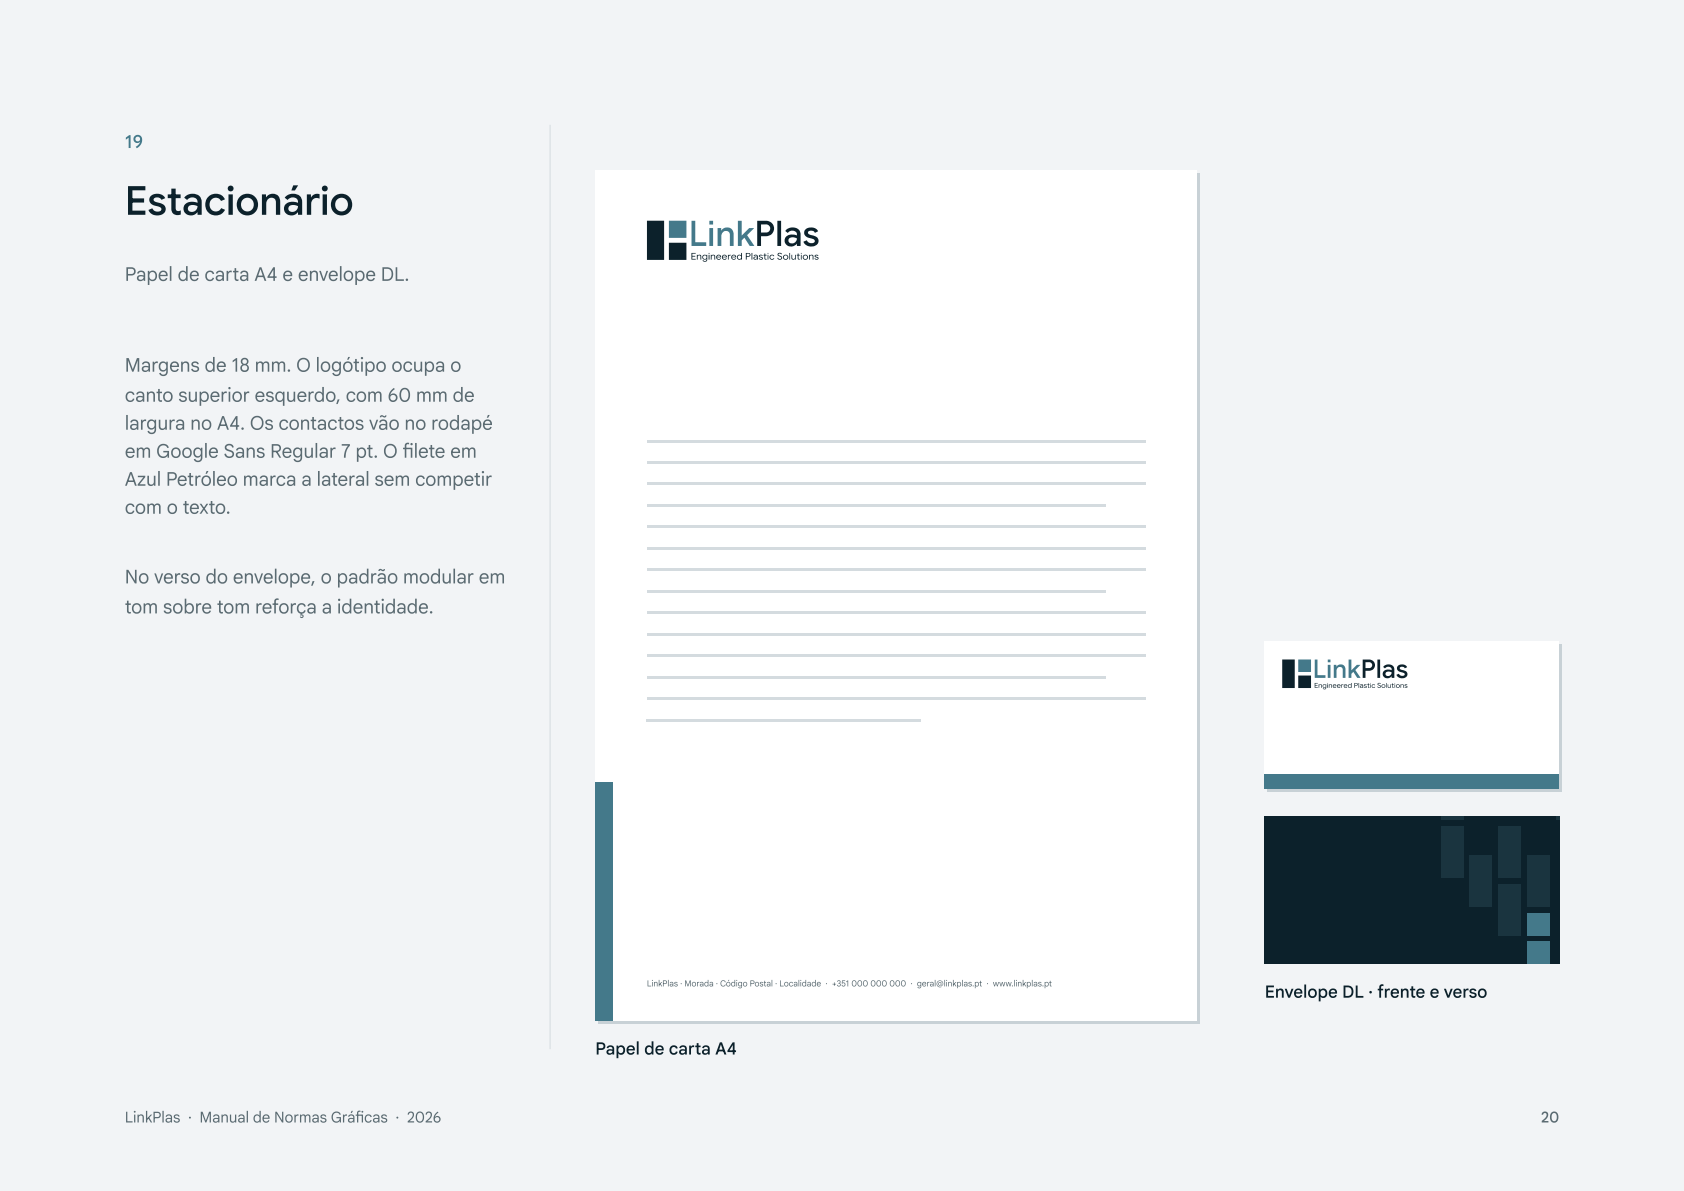
[picture p90: page 20]
com o texto.

Papel de carta A4 e envelope DL.

Margens de 18 mm. O logótipo ocupa o

canto superior esquerdo, com 60 mm de

largura no A4. Os contactos vão no rodapé

em Google Sans Regular 7 pt. O filete em

Azul Petróleo marca a lateral sem competir

No verso do envelope, o padrão modular em

tom sobre tom reforça a identidade.

LinkPlas · Morada · Código Postal · Localidade · +351 000 000 000 · geral@linkplas.pt · www.linkplas.pt

Envelope DL · frente e verso

Papel de carta A4

# Aplicações digitais

Assinatura de email, avatar e redes sociais.

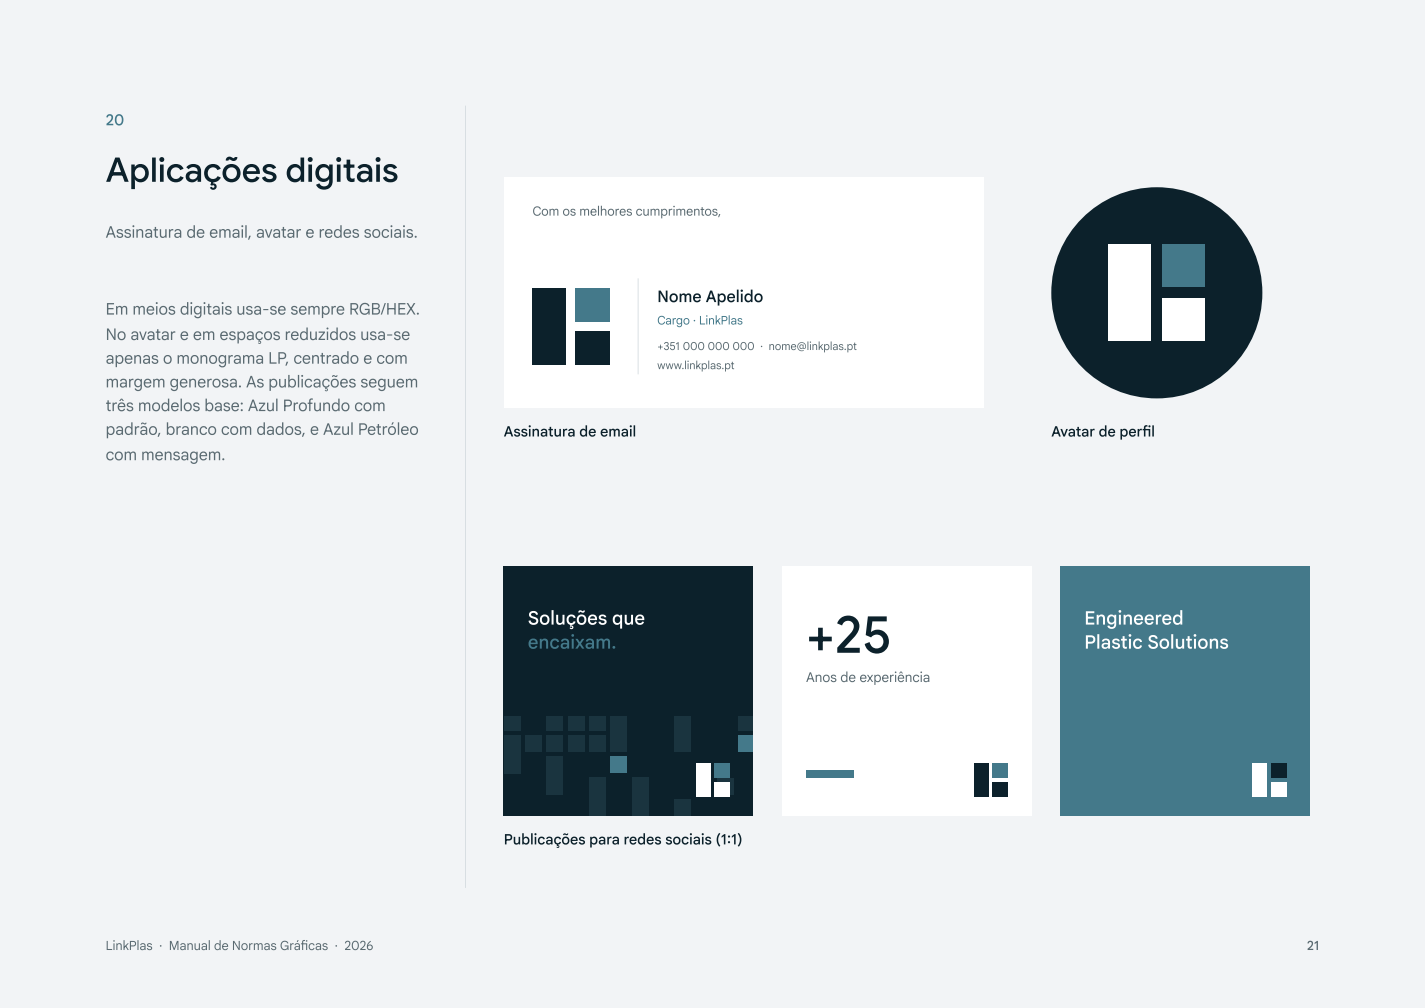
[picture p91: page 21]
com mensagem.; Nome Apelido; Cargo · LinkPlas; Assinatura de email; Avatar de perfil; Soluções que; encaixam.; Engineered; Plastic Solutions

Com os melhores cumprimentos,

Em meios digitais usa-se sempre RGB/HEX.

No avatar e em espaços reduzidos usa-se
apenas o monograma LP, centrado e com
margem generosa. As publicações seguem
três modelos base: Azul Profundo com
padrão, branco com dados, e Azul Petróleo

+351 000 000 000 · nome@linkplas.pt

www.linkplas.pt

Anos de experiência

Publicações para redes sociais (1:1)

21

# Ficheiros e formatos

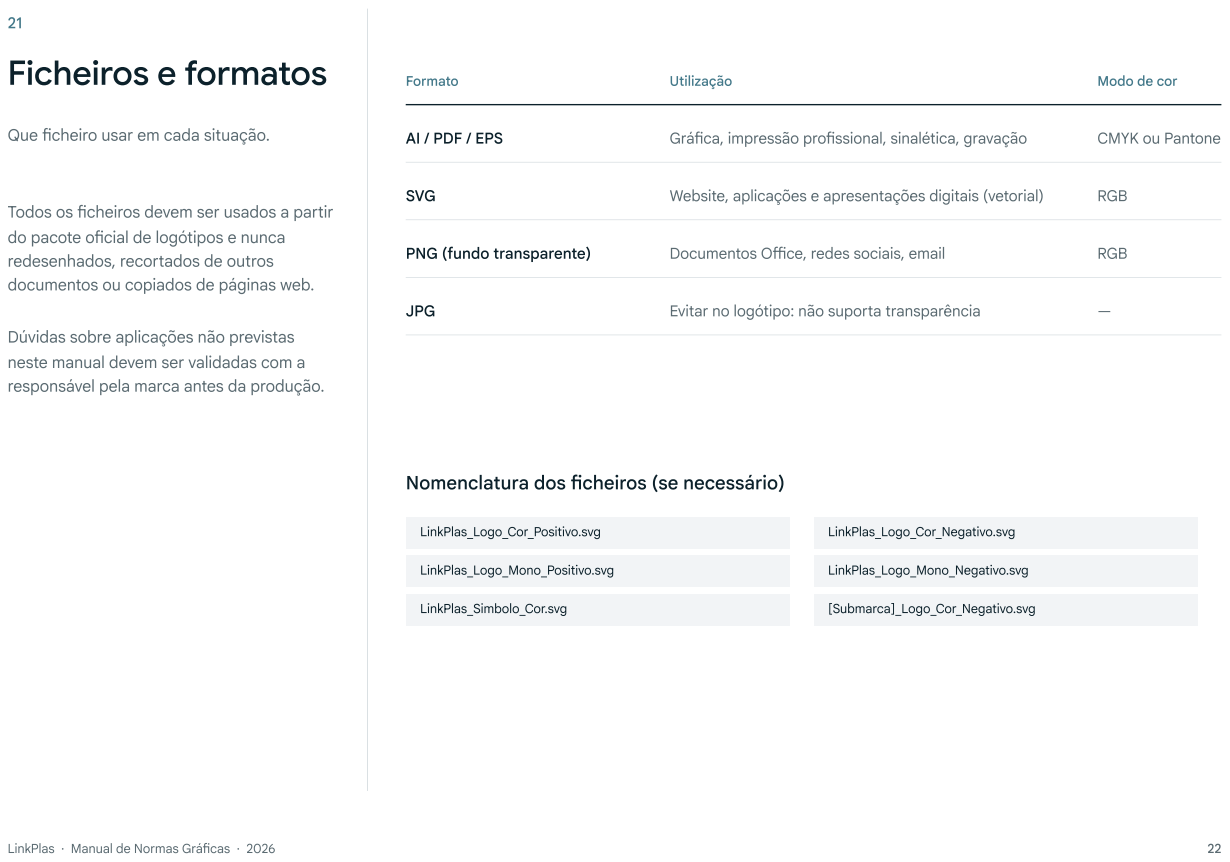
[picture p92: page 22]
Formato; Utilização; AI / PDF / EPS; Gráfica, impressão profissional, sinalética, gravação; SVG; Website, aplicações e apresentações digitais (vetorial); PNG (fundo transparente); Documentos Office, redes sociais, email; JPG; Evitar no logótipo: não suporta transparência; LinkPlas_Logo_Cor_Positivo.svg; LinkPlas_Logo_Cor_Negativo.svg; LinkPlas_Logo_Mono_Positivo.svg; LinkPlas_Logo_Mono_Negativo.svg; LinkPlas_Simbolo_Cor.svg; [Submarca]_Logo_Cor_Negativo.svg; RGB; LinkPlas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

Modo de cor

Que ficheiro usar em cada situação.

CMYK ou Pantone

Todos os ficheiros devem ser usados a partir
do pacote oficial de logótipos e nunca
redesenhados, recortados de outros
documentos ou copiados de páginas web.

Dúvidas sobre aplicações não previstas
neste manual devem ser validadas com a
responsável pela marca antes da produção.

Nomenclatura dos ficheiros (se necessário)

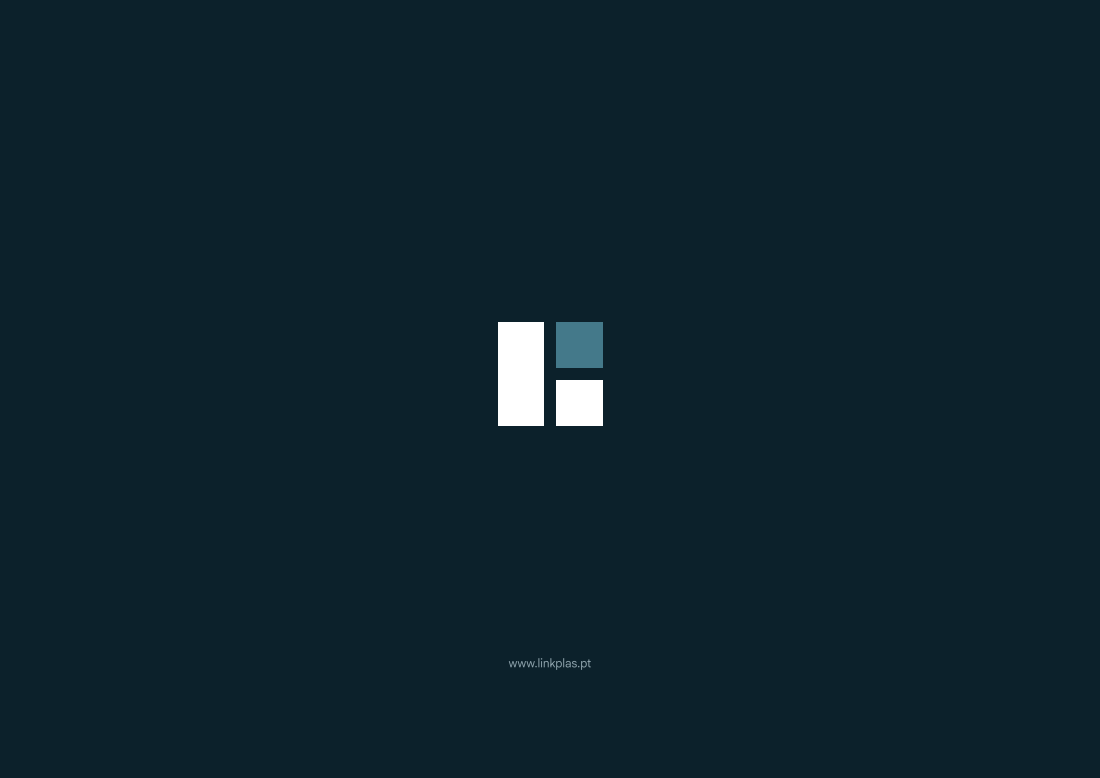
[picture p93: page 23]

www.linkplas.pt
