RochaDotPng/ProjectLinkplas/public/files/Anilha/7017030014.PDF

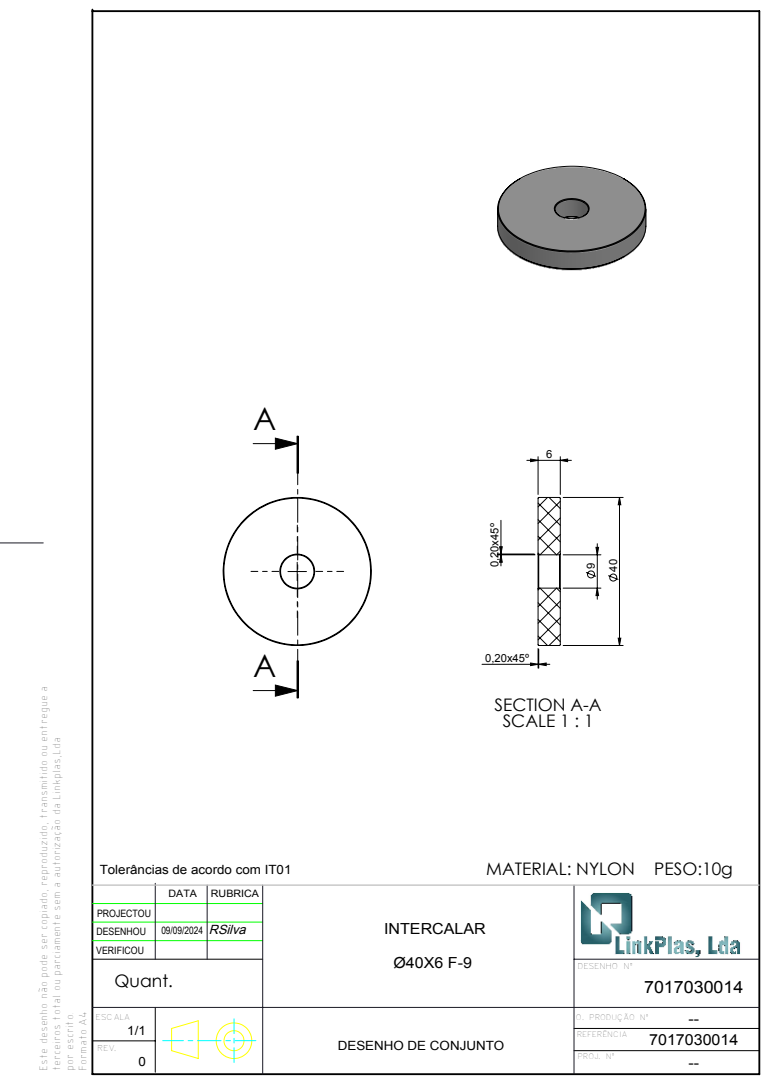
[picture p94: page 1]
SECTION A-A SCALE 1 : 1; por escrito.; Formato A4; O. PRODUÇÃO Nº; DESENHO Nº; PROJ. Nº; -- REFERÊNCIA

Este desenho não pode ser copiado, reproduzido, transmitido ou entregue a

terceiros total ou parciamente sem a autorização da Linkplas,Lda

Tolerâncias de acordo com IT01

MATERIAL: NYLON PESO:10g

DESENHO DE CONJUNTO
