RochaDotPng/ProjectLinkplas/public/files/TampaVeio/7017030009.pdf

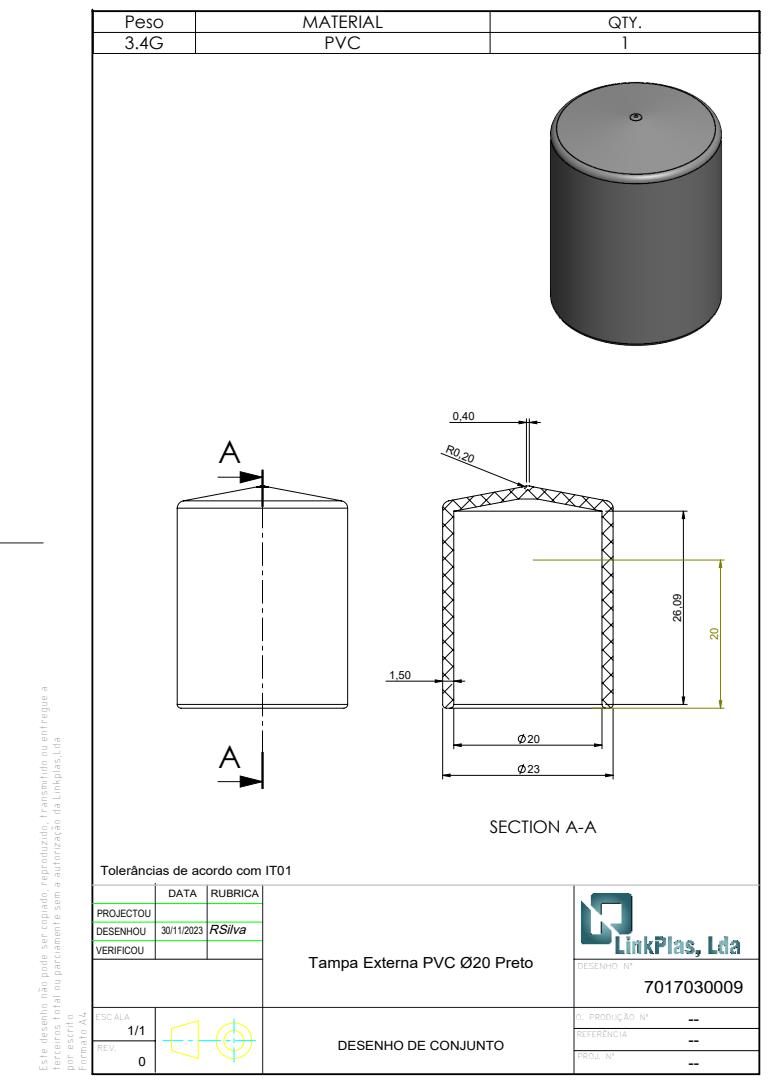
[picture p95: page 1]
SECTION A-A; por escrito.; Formato A4; O. PRODUÇÃO Nº; DESENHO Nº; PROJ. Nº; -- REFERÊNCIA

Peso | MATERIAL | QTY.
3.4G | PVC | 1

Este desenho não pode ser copiado, reproduzido, transmitido ou entregue a

terceiros total ou parciamente sem a autorização da Linkplas,Lda

Tolerâncias de acordo com IT01

DATA | RUBRICA Tampa Externa PVC Ø20 Preto

PROJECTOU
DESENHOU | 30/11/2023 | RSilva
VERIFICOU

DESENHO DE CONJUNTO
