RochaDotPng/ProjectLinkplas/public/files/TampaVeio/7017030011.pdf

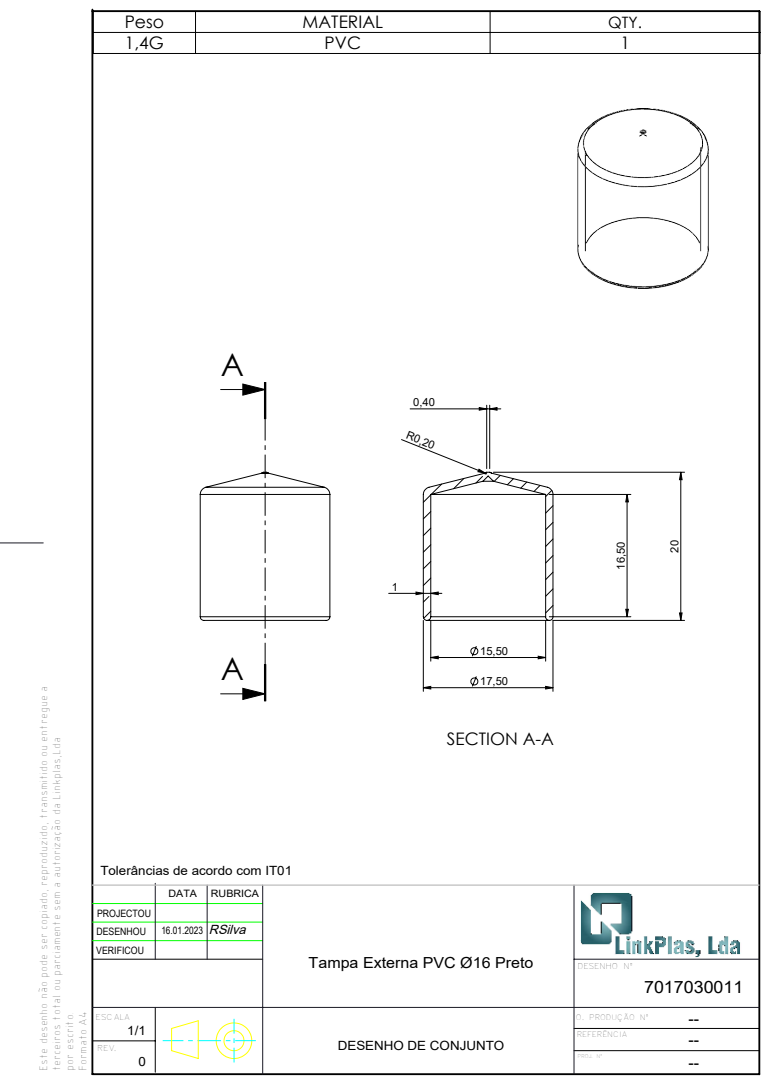
[picture p96: page 1]
SECTION A-A; por escrito.; Formato A4; O. PRODUÇÃO Nº; DESENHO Nº; PROJ. Nº; -- REFERÊNCIA

Peso | MATERIAL | QTY.
1,4G | PVC | 1

Este desenho não pode ser copiado, reproduzido, transmitido ou entregue a

terceiros total ou parciamente sem a autorização da Linkplas,Lda

Tolerâncias de acordo com IT01

DATA | RUBRICA Tampa Externa PVC Ø16 Preto

PROJECTOU
DESENHOU | 16.01.2023 | RSilva
VERIFICOU

DESENHO DE CONJUNTO
