RochaDotPng/ProjectLinkplas/(commit log)

2023-11-14 Criação da componente para a secção dos serviços
2023-11-16 O push que não fiz. tem os services, galeria e policy(não acabado). ajustes no footer
2023-11-18 Nova scrollbar. Adicionei uns estilos a pagina de sustentabilidade e reordenei os componentes na pagina principal
2024-03-06 added active status of button
2024-03-07 New product
    [7017030005.DWG, 7017030005.IGS, 7017030005.STEP, 7017030008.SLDPRT]
2024-03-07 File download on other products
    [7017030008.DWG, 7017030008.IGS, 7017030008.SLDPRT, 7017030008.STEP]
2024-03-07 added files for download
    [7017030011.DWG, 7017030011.IGS, 7017030011.SLDPRT, 7017030011.STEP, 7017030013.DWG, 7017030013.IGS, 7017030013.SLDPRT, 7017030013.STEP]
2024-03-08 commit de aço
2024-03-11 Added alts to pictures and decreased size of product buttons
2024-03-13 Responsive is done for phone and small laptops. Also included new file for download
    [7017030011.DWG]
2024-03-14 changed the amount of scroll for the button to show up
2024-03-18 added smooth position to scroll button
2024-03-27 added some buttons and changed some content
2024-04-04 moving files around
    [7017030005.SLDPRT, 7017030008.SLDPRT]
2025-02-15 Added new product. Added the data for the novidades e
    [7017030009.DWG, 7017030009.IGS, 7017030009.SLDPRT, 7017030009.STEP]
2025-02-15 Added missing files anda new social post
    [7017030014.IGS, 7017030014.SLDPRT, 7017030014.STEP, 7017030015.IGS, 7017030015.SLDPRT, 7017030015.STEP, 7017030016.IGS, 7017030016.STEP]
2026-10-02 products and product detail revamp
    [1000ML - 7017020003 base keepylink1000ml -1.STL, 1000ML - 8000000340 tampa 05101520 keepylink -1.STL, 1500ML. - 7017020004 base keepylink 1500ml-1.STL, 1500ML. - 8000000340 tampa 05101520 keepylink -1.STL, 2500ML - 7017020007 base keepylink2500ml-1.STL, 2500ML - 8000000349 tampa2540 keepylink -1.STL, 4000ML - 8000000349 tampa2540 keepylink -1.STL, 4000ML - base keepylink4000ml-1.STL]
2026-10-03 Refactored Hero section
    [7017030008.stl, 7017030011.stl, 7017030013.stl, 7017030015.stl]
2026-10-13 hidded ePharma and 4000ml tupperlink
